Quietmirror/dsh-new-repo/docs/V0.1_设计说明.md

# 右手指握轻量化鼠标 V0.1 一体式试握件 · 设计说明

> 状态：V0.1 试握件已生成并通过自动检查，可以打印。电子装配版只做了参考包络和干涉分析，**尚未设计**。
> 所有数值都可以在 `cad/params_v01.py` 中修改后重新生成；本文中的实测数值来自 `out/v0.1/report.json` 和 `slice_report.json`（自动生成的完整版见 [`out/v0.1/检查报告.md`](../out/v0.1/检查报告.md)）。

## 1 输入数据，以及怎样使用它们

| 数据 | 值 | 本版用途 |
|---|---|---|
| 腕横纹到中指尖 | ≈230 mm（照片 AR 近似） | 只用来判断手偏大、指握时掌根大概率落在鼠标后方，因此后部做短、做低。**不用于缩放外形** |
| 拇指尖到小指尖张开跨度 | ≈190 mm（照片 AR 近似） | 不是掌宽，也不是握宽。**不用于任何尺寸** |
| 掌宽、各指节长度、真实握姿 | 未测 | 没有编造。接触区位置先按经验放置并参数化，试握后再改 |
| 长 90 / 最大外宽 62 / 高 31 / 有效夹持宽 54 | 用户给的试握假设 | 作为构建目标，程序自动校准到这些值 |

Kotinos 用指节长度和屈曲角驱动接触面位置（`DataHand.scad`）。这里没有照搬，因为这些输入还没有测量；接触区改为直接用“位置 + 尺寸 + 深度”参数表达，测到指节数据后可以再接一个手部模型来推算这些参数。

## 2 参考项目

详见 [`参考来源与许可.md`](参考来源与许可.md)。概括：

- **olliebella**（CERN-OHL-P v2）：实际读了 README、22 个 STL（量尺寸、截面）、Fusion 存档的组件清单。采用紧凑比例、“周边框 + 斜筋 + 中部传感器框”的平面底格栅、**四角 + 后中**的五点脚贴布局、滚轮居前。引用了 7.5 mm 圆点脚贴、约 0.65 mm 脚贴厚度、lens-to-surface 2.4 mm、6×6×7.3 微动等数值。
- **Kotinos**（GPL-3.0）：读了 README 和全部 SCAD（MainBuild、DataHand、HandGenerator、PaddleSurfaceGenerator、Data*Paddle、HSK_PCB）及 STL。采用“用最少材料把脚贴、接触面、受力点连成开放骨架”的思路和“指腹接触面是连续光顺曲面片”的做法；接触区参数化。**没有沿用 HSK Pro 的主板孔位。**
- **paw3395-pcb**（CERN-OHL-P v2）：解析了 KiCad 板框和 PAW3395 封装。转接板 15.45×28.0×1.6，传感器开窗 8.6×17.26，镜头底面占位 19.0×21.75。传感器定位框的开口按这个占位加间隙取值。

olliebella 原生三键，这里另加了两个拇指侧键凸台。三个项目的源码和几何都没有复制，V0.1 的几何全部由本仓库代码生成。

## 3 坐标系与建模方法

坐标：X 向右（无名指/小指侧）为正，X=0 为两主键中线；Y=0 为最后端，向前为正；**Z=0 为五个脚贴平台底面**。贴上脚贴后，鼠标垫表面在 Z = −脚贴厚度。

建模流程（`cad/fingertip_mouse.py`）：

1. **外皮**：俯视轮廓（周期样条）的二维距离场，加上随高度变化的侧面偏移（拇指浅凹、无名指支撑、右侧托边），再与顶面高度场（驼峰曲线、横向拱度、两个主键指肚浅碟）做光滑求交，侧面和顶面的过渡圆滑。
2. **精确距离**：对外皮做 marching cubes，用 KD-tree 求每个体素到外皮的真实欧氏距离，因此 1.7 mm 壁厚处处一致（实测见第 6 节）。
3. **壳与骨架**：等厚壳、开放底面；减重窗口用圆角长孔并对边缘做圆滑处理；底部为周边法兰、承力筋、传感器框和五个平台；侧键凸台沿外皮法向长出，外表面随外皮弯曲。
4. **网格**：0.2 mm 体素 marching cubes（脚贴平面正好落在两层体素之间，因此 Z=0 是精确平面）。用 MeshLab 二次误差抽稀到 32 万面，再把抽稀产生的少量自相交面删除、局部补洞，最后复检。
5. **校准**：先用 0.4 mm 体素迭代 4 次，调整轮廓前后范围、名义半宽和右托边宽度，使长度 = 90、夹持宽 = 54、最大外宽 = 62。高度 31 由驼峰曲线直接决定。

可编辑源文件就是 `cad/*.py`，所有参数集中在 `cad/params_v01.py`。另外提供：

- `outer_skin_nurbs_ref_v01.step`：沿 Y 取 56 个外皮截面放样得到的 NURBS 实体，与 SDF 外皮的偏差见第 6 节。用于在 Fusion / SolidWorks 中做装配版的抽壳、分件和开孔。首尾各有约 0.25 mm 的平面端盖。
- `electronics_envelopes_v01.step`：电子参考包络装配体（B-rep）。
- 把带窗口和骨架的试握件转成三角面 STEP 也试过：4 万面就有约 98 MB，没有实用价值，所以没有提供。

## 4 主要参数（默认值）

| 分类 | 参数 | 值 | 说明 |
|---|---|---|---|
| 尺寸 | 长 / 最大外宽 / 高 / 夹持宽 | 90 / 62 / 31 / 54 | 目标，自动校准 |
| 轮廓 | 名义半宽 `plan.half_width` | 校准后约 28.1 | 侧壁名义半宽（不含凹、托边） |
| 驼峰 | `top.crest` | 峰在 Y≈0.54L，后端 0.36H | 后部短而低，避免顶掌 |
| 顶面 | 横向下降 `crown_drop` | 后 7 → 前 3 mm | |
| 主键浅碟 | LMB (−14, 77)，RMB (14, 78.5) | 7.5×10.5 椭圆，深 0.9 | 指肚接触区，连续曲面，无开孔 |
| 拇指浅凹 | Y 54 ±18，Z 10.5 ±7.5 | 深 1.6 | 夹持宽的拇指测点在凹底 |
| 无名指支撑 | Y 66 ±14，Z 12 ±8 | 深 0.5 | |
| 右侧托边 | Y 0.30L–0.72L（两端各 0.14L 渐变），Z 0–9.5 | 校准后外伸约 4.3 | 小指 / 无名指防拖地 |
| 侧键凸台 | 前 SB_front (Y 61.5, Z 20.5)，后 SB_rear (Y 43, Z 20.5) | 15.5×7，凸起 1.6，前端低 4°；边缘约 R1.3；下沿 58° 斜面 | 固定，仅试触达；斜下沿免支撑 |
| 滚轮 | 轴 Y=75.5；开口 9.6×22，R3 角，边缘圆滑 1.6 | 固定滚轮 Ø20×7，露出 2.6 | 18 道浅防滑槽 |
| 壳 | 壁厚 `shell.wall` | 1.7 | 0.4 喷嘴首轮 |
| 底部 | 周边法兰 2.5 宽 × 3 高；承力筋 2.5 宽 × 3 高 | | 筋间 0.8 圆角 |
| 脚贴平台 | Ø8.5，距外轮廓 6 mm | 适配 7–7.5 mm 圆点脚贴 | 四角 + 后中 |
| 传感器框 | 中心 (0, 45)，外 26×30，筋 2.5 | 内开口 21×25 | 容纳镜头占位 19.0×21.75 |
| 底边 | 外缘 45° 倒角 0.6 | | 防硌手、抑制象脚 |
| 窗口 | 顶部 2 条长孔 + 后顶 1 + 左后 1 + 右后 1 + 前脸 1 | 边缘圆滑 1.2 | 均离开接触区 ≥ 2 mm |

## 5 结构说明

**外形**。驼峰最高点在 Y≈48.6，后端低（后端顶约 11 mm），整体后部较短。俯视轮廓前宽后窄，后部收成蛋形。左侧拇指区是一个 1.6 mm 的浅凹，凹下方外壁回到名义位置，形成可以托住拇指的下沿，抬鼠时拇指有着力点。右侧中部有 0.5 mm 的无名指支撑浅凹；下部向外伸出约 4.3 mm 的托边，外表面是内凹曲面，小指可以搭在上面而不拖地。

**侧键凸台**。外表面随外皮弯曲，顶边和两端是清晰的圆角台阶，拇指能摸出位置；下沿做成 58° 斜面。拇指从浅凹向上滑就能顶到侧键，而且打印时下沿不需要支撑，不会在拇指接触面上留下支撑痕。

**接触区不开孔**。主键指肚浅碟、拇指浅凹、无名指支撑、小指托边、两个侧键凸台全部是连续光顺曲面。程序检查了每个接触区到最近减重窗口和滚轮开口的距离（第 6 节）。滚轮开口边缘、侧键凸台边缘、窗口边缘都做了圆滑过渡（约 R1–1.4）；外缘底边是 0.6 mm 倒角。

**开放骨架**。顶部驼峰后坡两侧各开一条 8.5×30 的长孔，中间保留 10.5 mm 的脊梁；后顶一个横向小孔；左后、右后侧壁各一个斜向长孔；前脸一个横向长孔。底面大部分开放。

**底部承力路径**。周边法兰沿外壁内侧围一圈；承力筋从五个平台出发，在中部汇到传感器框；前横筋连接两个前平台；传感器框左右各有一根横向拉筋连到侧壁，正好在拇指 / 无名指夹持的高度下方，提高夹持刚度。五个平台、法兰、筋和传感器框都在 Z=0 平面内，**由同一个平面切出，严格共面**，并连成一个实体。

> 关于“只保留五个平台”：V0.1 中法兰和筋的底面也在 Z=0（与 olliebella 底板相同）。这样整块底面直接贴床打印，不需要支撑，共面性也最好。贴上脚贴后，筋底距垫面等于脚贴厚度（约 0.65 mm）。如果在软布垫上发现筋刮垫，可以把 `bottom.bottom_relief` 设为 0.3–0.5，让平台以外的部分抬高；代价是这些部分在打印时悬空，需要支撑。

**V0.1 占位件（装配版删除）**。固定滚轮装在一个立在前横筋和中纵筋上的底座上，与外壳之间留约 1.2 mm 间隙，不碰开口边缘。两个主键浅碟正下方各有一根 Ø4.5 受力柱，从前横筋立到壳内，用来模拟按键支撑，避免试握时顶面发软。

## 6 自动检查结果

（`out/v0.1/report.json`，完整表格见 `out/v0.1/检查报告.md`）

| 检查项 | 结果 |
|---|---|
| 尺寸 长 × 宽 × 高 | **90.02 × 62.02 × 31.00**（目标 90 × 62 × 31）；PrusaSlicer 读入 62.02 × 90.02 × 31.00 |
| 有效夹持宽 | **54.00**：拇指测点 (−26.6, 54, 10.5) 到无名指测点 (27.4, 66, 12) 的 X 向距离 |
| 外壳宽（不含侧键凸台） | 60.64；侧键凸台另外凸出约 1.5 |
| 单一连通实体 | 是：STL 写盘后回读为 1 个实体，PrusaSlicer `parts = 1` |
| 封闭网格 | 是：0 边界边、0 非流形边、0 退化面；manifold3d 通过；PrusaSlicer `manifold = yes` |
| 自相交 | **0**（MeshLab，检测对象是写盘后的 float32 STL）。原始 marching-cubes 网格 143 万面，0 自相交；抽稀到 32 万面后，在受力柱侧面和前角内壁出现 12 个，已删除并局部补洞。交付网格与原始网格的 Hausdorff 距离最大 0.069 mm |
| 最薄壁 | 外壳 P1 1.69 / 中位 1.70，最小 1.40（单个点，右后窗口附近）。窗口和滚轮开口的圆角收边最小 0.95、P5 1.50，属于圆角收口，符合预期 |
| 五脚共面 | 五个平台由同一平面 Z=0 切出；回读 STL 后底面顶点 Z 偏差 ≤ 0.003 mm（float32 舍入量级）；每个平台都能完整放下 7.5 mm 圆点脚贴 |
| 接触区避让 | 所有减重窗口距接触区 ≥ 3.7 mm（要求 ≥ 2）；主键浅碟距滚轮开口 1.73 / 1.87 mm（要求 ≥ 1.5） |
| 固定滚轮 | 与外壳最小间隙 1.19 mm，高出两侧顶面 2.6 mm |
| 体积 | 21.05 cm³ = 壳 13.45 + 底部法兰 1.73 + 筋/传感器框/平台 2.41 + 占位件 3.44 |
| 估重 | 100% 实心 PLA 26.1 g；切片后零件本体 **25.2 g**（2 h 35 min），连同树状支撑共耗材 **37.3 g、约 4 h 06 min** |
| 支撑是否碰外表面 | 位于外皮以外、离零件 < 0.6 mm 的支撑挤出点只有 2 个（左后窗口下沿附近）；指肚区、拇指区、侧键、托边都没有支撑 |
| NURBS 参考面 | 有效 B-rep，相对 SDF 外皮最大偏差 0.015 mm |

（PLA 26.1 g 中有 3.44 cm³ ≈ 4.3 g 是装配版会删除的占位件。）

## 7 打印

- **朝向**：按模型原样放置，底面（五个平台和底格栅）贴床，Z 向上，不需要旋转。切片器里核对尺寸应为 X 62.0 × Y 90.0 × Z 31.0（PrusaSlicer `--info` 读数见第 6 节）。
- **支撑**：只开“仅从热床生成”的树状 / organic 支撑。需要支撑的是壳体内顶面（驼峰内侧）、窗口上沿、滚轮下半圈两侧和受力柱顶端，见 `img/overhang_sheet.png`（悬垂 > 45° 共约 2800 mm²，几乎全在 Z 15–30 的壳内顶面）。侧键凸台下沿已经做成 58° 斜面，不需要支撑。`cad/support_check.py` 解析 G-code 的结果：外皮以外、贴近零件的支撑挤出点只有 2 个（左后窗口下沿）。指肚区、拇指区、侧键、托边都不碰支撑，支撑从开放底面和窗口取出。
- **参数**：0.4 喷嘴，0.2 层高，3 圈壁（1.7 mm 壁基本全由周长线组成），顶底 4/3 层，填充 20% gyroid（只影响平台和筋），首层象脚补偿 0.15。配置文件 `cad/prusa_v01.ini`。
- **材料**：PLA 即可；希望更接近成品手感可用 PETG。
- **后处理**：拆支撑；用平板加细砂纸轻磨五个平台，然后贴脚贴，并记录脚贴实测厚度。
- **核对**：在玻璃板上检查五脚是否同时着地；测量长、宽、高和夹持宽（拇指测点 Y54 Z10.5、无名指测点 Y66 Z12）。

## 8 电子装配版：参考包络、尺寸链和干涉

目标配置：PAW3950、2.4 GHz 无线 1000 Hz、左右主键、中键 / 滚轮、两个拇指侧键。
供体是用户称为“ATK 蜻蜓 A1 Plus”的鼠标，或半组装的自制主板。**供体的具体型号、传感器版本、PCB 外形和孔位都没有确认**，所以本节不假定它使用 PAW3950，也没有给出任何供体孔位。PAW3950 只是传感器型号，不对应统一的主板尺寸。无线 1K 要靠主板、固件和配套接收器共同实现，与外壳无关，这里只为天线留出净空。

包络来源标记：**M** 从开源文件实测，**B** 来自参考 BOM / README，**S** 行业常见标称，**E** 估计。E 类只用来预留空间，**不是装配尺寸，也不是孔位**。

| 包络 | 尺寸 / 位置 | 来源 |
|---|---|---|
| 镜头底面占位 | 19.0×21.75，光学中心偏置按封装，Z 1.75–3.0 | M（paw3395-pcb B.CrtYd）+ 尺寸链 |
| 传感器本体 PAW3950 | 12.5×18×4.5，板上 | E |
| 参考转接板 | 15.45×28.0×1.6，光学中心偏 4.6 | M（paw3395-pcb） |
| 主键微动 L/R | 6×6×7.3，在两浅碟下 | B（olliebella BOM） |
| 滚轮 / 轴 / 编码器 / 中键 | Ø20×7；轴 Ø2×19；编码器 6.5×12.5×(到轴心+6.25)；中键 6×6×5 | E |
| 侧键微动 ×2 + 侧键小板 | 6×6×4.3；板 34×10×1.0，平行于拇指侧内壁 | E |
| 电池 | 301230（30×12×3.0）；备选 602030（30×20×6.0），平放后部 | B / E |
| 电池插头 | PH2.0 2P 6×4.5×6 | E |
| USB-C | 插座 8.94×7.35×3.26，前脸居中；插头护套净空 12.4×15×6.6 | S/E |
| 电源开关 | 9×4×3.5，挂在主板下方，从底面拨动 | E |
| 2.4 GHz 天线净空 | 8×18×9，主板右前角 | E |
| 走线 | Ø2 线束：侧键板→主板，电池→主板 | E |

**Z 向尺寸链**（传感器轴线垂直于垫面，PCB 必须平行于 Z=0）：

```
垫面            z = −t_skate                          = −0.65   (t_skate：脚贴实测厚度，估计)
镜头基准面      z = −t_skate + d_lens_surface          =  1.75   (d = 2.40 ±0.2，olliebella README；以镜头 datasheet 为准)
PCB 底面        z = 镜头基准面 + h_lens→PCB             =  3.00   (h_lens→PCB = 1.25 为估计值，必须实测)
PCB 顶面        z = PCB 底面 + t_PCB                   =  4.60   (t_PCB = 1.6，转接板实测；供体未知)
```

V0.1 的筋顶在 Z=3.0。只有当 h_lens→PCB 实测正好是 1.25 时，主板才能直接平放在筋上。若实测更大，需要加垫高柱；若更小，传感器框和附近的筋要局部降低。PCB 底面高度只能由“真实主板 + 镜头 + 底面 + 脚贴”的尺寸链确定，不能用 V0.1 的筋高反推。

**干涉结论**（`out/v0.1/检查报告.md` 第 8 节；图见 `img/envelopes_sheet.png`、`img/sections_sheet.png`）：

1. **编码器：干涉，侵入 0.85 mm → 需改布局或壳体。** 滚轮 Ø20、高出顶面 2.6 mm，轴心在 Z≈18.1，比估计的 PCB 顶面（4.6）高 13.5 mm。估计的编码器本体上沿到轴心 +6.25，即 Z≈24.4，撞到滚轮开口旁的外壳内顶面。可选办法：按选定编码器核对轴高；把滚轮换成 Ø18 或减少露出量，降低轴心；把滚轮区外壳局部加高；或者用独立的滚轮支架小板。
2. **USB-C：需要在前脸开口。** 插座前端应贴齐前脸，需要在 Z≈3.6–6.9、X ±4.5 处开约 10×4.5 mm 的口。V0.1 前脸窗口在 Z 5–10，位置对不上，装配版应把它改成 USB-C 开口，或把窗口移开。插头护套下沿离垫面约 3 mm，可以接受。插座后端在前横筋之前，不干涉。
3. **电源开关：干涉，且穿过离地余量 → 需改选型或布局。** 按“挂在主板下方、从底面拨动”布置时，主板底面（Z 3.0）以下只有 3.0 mm，再留 0.5 mm 离地余量，只剩 2.5 mm。估计 3.5 mm 高的开关加拨杆会低于脚贴平面 0.47 mm，还会撞筋。可选办法：选总高 ≤ 2.3 mm 的超薄拨动开关，放在筋之间的空档；或者用装在主板边缘的侧拨开关，从侧壁窗口拨动；或者改成按键式开关。
4. **电池：可行。** 301230 平放在后部筋上（垫 0.5 mm 泡棉），最小间隙 0.68 mm。602030 也放得下（间隙 0.5 mm），但会和按 301230 布置的插头位置重叠，换大电池时插头要挪到电池侧面。
5. **侧键：可行。** 两个侧键微动（估计 6×6×4.3）贴在凸台内侧，接触深度 ≤ 0.13 mm，是有意的贴合；侧键小板离内壁 0.53 mm。具体高度要按选定的开关重新算。
6. **主键：可行，但需要压杆。** L/R 微动（6×6×7.3）放在浅碟正下方的主板上，顶部到外壳内表面还有约 10 mm，需要按键压杆。V0.1 受力柱的位置就是将来微动 / 压杆的位置。
7. **传感器：可行。** 镜头占位 19.0×21.75（M）落在传感器框 21×25 的开口内，四周间隙 ≥ 1.0 mm；PAW3395 参考转接板平放在筋顶（接触 0.1 mm，那是支承面）。PCB 底面的真实高度取决于实测的 h_lens→PCB，见上面的尺寸链。
8. **天线净空：可行。** 放在主板右前角，范围内只有塑料（外壳和筋），与电池、编码器、走线都不重叠；右主键微动在它前方约 4.5 mm，最终以天线厂商的净空要求为准。
9. **主板可用最大外形**：Z 3.0–7.6、离壁 0.5 mm 的可用区域包围盒约 X −25.6…26.2、Y 3.7…87.9，面积约 3900 mm²（`main_board_keepin_outline.dxf/.csv`）。这是外壳允许的上限；扣掉后部电池区（Y 约 11–33）后，主板实际可用约 Y 33–88。测到供体主板后先和这条轮廓比较：放不下就改壳体尺寸或改板型（例如把传感器做成独立小板）。

**结论**：按当前估计包络，V0.1 外形可以容纳传感器、主键 / 侧键、电池和天线净空。编码器高度、USB-C 开口和电源开关三处需要在装配版中改布局或选型；改哪一处要等真实尺寸确定。

## 9 装配版待测尺寸清单

**供体 / 主板**

1. 供体的准确型号、PCB 版本号，以及传感器丝印（是否为 PAW3950、具体后缀）
2. 主板外形轮廓（建议平板扫描 + 卡尺）、厚度、所有安装孔的位置和孔径
3. 主板正面 / 背面最高元件高度，以及禁止压到的区域
4. 传感器光学中心在主板上的坐标，镜头型号，镜头卡扣形状
5. 镜头基准面到 PCB 底面的高度 h_lens→PCB，以及镜头底面到垫面的设计距离 d_lens_surface（datasheet）
6. 主键微动型号、本体尺寸、触点高度（相对 PCB 顶面）、行程和动作力
7. 编码器型号、安装方式、轴心相对 PCB 的高度，滚轮直径、宽度、轴长和轴径
8. 中键微动的位置和高度
9. 侧键微动型号；侧键小板外形、孔位和排线长度
10. 电池型号、尺寸（含保护板）、插头型号及线长
11. 天线类型和位置（PCB 天线 / 陶瓷天线 / 外接），厂商要求的净空
12. USB-C 插座位置、离 PCB 的高度、插头护套尺寸
13. 电源开关位置、拨杆方向、行程
14. 主板与侧键板、编码器之间的连接方式（排线 / 焊线）及走线路径

**手和使用**

15. 掌宽、各指节长度、指握姿态下拇指 / 无名指 / 小指的实际触点（用 V0.1 试握件标记）
16. 实际使用的脚贴直径和厚度、鼠标垫软硬

**打印件**

17. V0.1 实测外形尺寸和五脚共面性，与模型对比（确认打印机的尺寸补偿）

## 10 试握反馈

按 [`试握反馈表.md`](试握反馈表.md) 逐项记录，重点看：

1. **握宽**：拇指浅凹和无名指支撑之间的 54 mm 是否合适；托边宽度
2. **顶掌**：掌心 / 掌根是否碰到驼峰或后部
3. **手指拖地**：无名指、小指、拇指是否拖垫；托边是否起作用
4. **滚轮 / 侧键触达**：食指移到滚轮、拇指上移到两个侧键是否需要改握姿
5. **抬鼠稳定性**：抬起时是否滑脱、翻转；放下时五脚是否同时着地

## 11 下一轮（V0.2）计划

- 按试握反馈改长宽高、接触区和侧键位置（都只需改 `params_v01.py`）
- 壁厚逐轮减到 1.4 → 1.2 mm，顶部和侧壁窗口加大，筋高 3 → 2.5 mm；以切片重量和夹持刚度为准
- 测到供体尺寸后：删除占位件，按真实主板做安装柱 / 卡扣、镜头卡位和 USB-C 开口，主键和侧键改为分体活动件，并按上一节的干涉结论调整布局
