Quietmirror/dsh-new-repo/docs/试握反馈表.md

# V0.1 试握反馈表

打印件：`out/v0.1/fingertip_v01_trial_grip.stl`。先贴好五个圆点脚贴（记录脚贴厚度），在常用鼠标垫上以平时的指握姿势使用。
主键、侧键和滚轮在 V0.1 中都是固定的，这一轮只评价外形和能否够到，不评价点击手感和回弹。

每项打分 1–5（3 = 合适），写清方向和大致幅度（mm），例如“握宽 2：太宽，约窄 2 mm”。

## 0 基本信息

| 项目 | 记录 |
|---|---|
| 打印材料 / 壁厚设置 / 实际重量 (g) | |
| 脚贴型号、直径、实测厚度 (mm) | |
| 鼠标垫类型（布垫软/硬、玻璃、树脂） | |
| 平时使用的鼠标型号与尺寸（对照） | |
| 使用场景（FPS 跟枪 / 甩枪 / 办公） | |

## 1 握宽（夹持宽 54 mm，最大外宽 62 mm）

| 问题 | 分数 | 说明 |
|---|---|---|
| 拇指与无名指之间的夹持宽度：太窄 1 … 5 太宽 | | |
| 拇指浅凹的位置（前后、高低）与深度 | | 拇指实际落点 Y≈___ Z≈___ |
| 右侧无名指支撑面的位置 | | 无名指实际落点 Y≈___ Z≈___ |
| 右侧托边（防拖地）宽度 / 高度：小指是否舒服地搭在托边上 | | |
| 夹紧时是否感到外壳变形或发出响声 | | |

## 2 顶掌（高 31 mm，后部短低）

| 问题 | 分数 | 说明 |
|---|---|---|
| 正常指握时掌心 / 掌根是否碰到背部 | | 碰到的位置 Y≈___ |
| 驼峰高度：太低 1 … 5 太高 | | |
| 驼峰前后位置：太靠后 1 … 5 太靠前 | | |
| 长度 90 mm：太短 1 … 5 太长 | | 指尖到前沿的余量 ___ mm |

## 3 手指拖地

| 问题 | 分数 | 说明 |
|---|---|---|
| 无名指 / 小指是否拖到鼠标垫 | | 哪根手指，什么动作时 |
| 拇指是否拖到鼠标垫 | | |
| 托边下缘是否刮垫（重压、斜压时） | | |

## 4 滚轮 / 侧键触达

| 问题 | 分数 | 说明 |
|---|---|---|
| 食指从主键移到滚轮是否顺手（滚轮 Y≈75.5） | | 希望前移/后移 ___ mm |
| 滚轮露出高度（约 2.6 mm）与开口宽度 | | |
| 前侧键（SB_front，Y≈61.5，Z≈20.5）能否不改握姿按到 | | |
| 后侧键（SB_rear，Y≈43，Z≈20.5）能否不改握姿按到 | | |
| 侧键高度：太低 1 … 5 太高；凸起 1.6 mm 是否足够分辨 | | |
| 两侧键间距是否容易误触 | | |
| 主键指肚浅碟位置（LMB X=-14 Y=77，RMB X=14 Y=78.5） | | 指肚实际落点 |

## 5 抬鼠稳定性

| 问题 | 分数 | 说明 |
|---|---|---|
| 抬起时是否容易滑脱 | | |
| 抬起时是否左右翻转 / 前后倾斜 | | |
| 放下时五个脚贴是否同时着垫，有无翘动 | | |
| 重心感觉（前 / 后 / 左 / 右） | | |

## 6 其他

| 问题 | 记录 |
|---|---|
| 窗口边缘、凸台边缘是否硌手 | |
| 表面层纹、支撑残留是否影响判断 | |
| 最想改的三处（按优先级） | 1. 2. 3. |

## 7 附加测量（建议同时补充）

- 掌宽（掌指关节处）、食指 / 中指 / 无名指 / 小指 / 拇指各指节长度
- 指握姿态下：指尖到掌根距离；手掌离桌面的高度
- 打印件实测：长、宽、高、五脚是否共面（放在玻璃板上用塞尺检查）
