Quietmirror/dsh-new-repo/out/v0.1/检查报告.md

# V0.1 试握件自动检查报告

由 `cad/build_v01.py` 生成的 `report.json` 转写；数值均为本次构建实测，单位 mm。

## 1 外形尺寸（网格包围盒，Z 自脚贴平台平面起算）

| 项目 | 目标 | 实测 |
|---|---|---|
| 长 Y | 90.0 | 90.02 |
| 最大外宽 X（含右托边、侧键凸台） | 62.0 | 62.02 |
| 外壳宽（不含侧键凸台） | — | 60.64 |
| 高 Z（贴脚贴后约 +0.65） | 31.0 | 31.00 |
| 有效夹持宽（拇指点→无名指点，X 向） | ≈54 | 54.00 |

拇指测点 (-26.6, 54.0, 10.5)，无名指测点 (27.4, 66.0, 12.0)。

## 2 网格检查（交付 STL）

| 项目 | 结果 |
|---|---|
| 面数 / 顶点数 | 319780 / 159856 |
| 封闭（watertight） | True |
| 实体数（连通分量） | 1 |
| 边界边 / 非流形边 / 退化面 | 0 / 0 / 0 |
| 自相交面（MeshLab） | 0 |
| manifold3d 校验 | Error.NoError |
| 体积 | 21.05 cm³ |
| 原始 marching-cubes 网格 | 1431776 面，封闭=True，实体=1，自相交=0 |
| 抽稀后自相交修复（每轮检出面数，按 float32 精度） | [12, 0]，修复位置 [[-23.0, 83.9, 6.2], [-11.9, 79.5, 12.4], [-16.1, 77.9, 6.0], [23.6, 83.2, 6.6], [12.1, 77.5, 17.0], [16.1, 77.9, 8.4]] |
| 交付网格 vs 原始网格 Hausdorff | 最大 0.069，平均 0.0004 |

## 3 五个脚贴平台

| 平台 | 中心 X, Y | 平台内底面面积 mm² | 底面 Z 范围 | 7.5 mm 圆点脚贴完全落在平面上 |
|---|---|---|---|---|
| RC | 0.0, 5.78 | 51.0 | 0.0000 … 0.0011 | True |
| RL | -19.98, 23.4 | 50.9 | 0.0000 … 0.0026 | True |
| RR | 23.47, 23.4 | 52.2 | 0.0000 … 0.0000 | True |
| FL | -19.44, 78.75 | 52.4 | 0.0000 … 0.0027 | True |
| FR | 19.44, 78.75 | 51.6 | 0.0000 … 0.0000 | True |

五平台底面顶点 Z 最大偏差 **0.0027 mm**；全模型最低点 Z = 0.0000。

## 4 壁厚（沿内法向射线穿过实体场，亚体素插值）

| 区域 | 样本 | 最小 | P1 | P5 | 中位 |
|---|---|---|---|---|---|
| 外壳（排除窗口/滚轮开口圆角 1.5 mm 带） | 72154 | 1.40 | 1.69 | 1.70 | 1.70 |
| 窗口/滚轮开口圆角边 | 13014 | 0.95 | 1.25 | 1.50 | 1.70 |

薄点（< 1.4 mm，已排除圆角边）：

| 位置 X,Y,Z | 最小 | 顶点数 |
|---|---|---|
| [16.0, 7.0, 12.0] | 1.40 | 1 |

## 5 接触区与开孔

| 接触区 | 距最近减重窗口 | 距滚轮开口 | 通过 |
|---|---|---|---|
| lmb_dish | 10.48 | 1.73 | True |
| rmb_dish | 3.71 | 1.87 | True |
| thumb_groove | 4.27 | 22.49 | True |
| ring_rest | 14.60 | 19.07 | True |
| pinky_lip | 6.88 | 22.97 | True |
| boss_SB_front | 14.15 | 18.93 | True |
| boss_SB_rear | 4.46 | 25.76 | True |

固定滚轮占位件与外壳最小间隙 1.19 mm；滚轮顶 Z=28.11，该处外壳顶面 Z=25.51。

## 6 体积 / 重量

| 部分（体素估计） | 体积 cm³ |
|---|---|
| shell_with_windows_and_side_bosses | 13.45 |
| bottom_perimeter_flange | 1.73 |
| ribs_sensor_frame_pads | 2.41 |
| v01_placeholders_wheel_and_posts | 3.44 |

实体体积 21.05 cm³ → 100% 实心估重 PLA 26.11 g / PETG 26.74 g。

切片（PrusaSlicer CLI，`cad/prusa_v01.ini`：0.4 喷嘴、0.2 层高、3 圈壁、20% gyroid、PLA 1.24 g/cm³）：

| 方案 | 耗材 g | 耗材 m | 预计时间 | 层数 |
|---|---|---|---|---|
| 零件本体（不含支撑） | 25.17 | 8.44 | 2h 34m 43s | 155 |
| 实际打印（含树状支撑） | 37.29 | 12.50 | 4h 6m 9s | 155 |

切片器读入尺寸：62.022278 × 90.018553 × 31.000477，manifold=yes，parts= 1，volume=21052.451172。

支撑位置检查（`cad/support_check.py`，以 NURBS 外皮为界）：支撑挤出点 221501，其中接触面（interface）2638；**外皮以外、距零件表面 < 0.6 mm 的支撑点 2**；外皮以外的全部支撑点 9625（多为树状支撑在热床上的底座）。

外皮以外的支撑分布（10 mm 网格）：{'x-30 y10 z0': 1, 'x-30 y20 z5': 1}

## 7 悬垂（打印朝向：底面贴床）

悬垂 > 45° 面积 2801 mm²，贴床面积 1580 mm²；按高度分布：{'0-5': 1, '5-10': 2, '10-15': 84, '15-20': 320, '20-25': 1000, '25-30': 1394, '30-35': 0}。

## 8 电子参考包络干涉（骨架已删除 V0.1 占位件）

尺寸链（Z）：mousepad_surface_z = -0.65，lens_reference_plane_z = 1.75，pcb_bottom_z = 3.00，pcb_top_z = 4.60

| 包络 | 来源 | 状态 | 与骨架重叠 mm³ | 最大侵入 mm | 最小间隙 mm |
|---|---|---|---|---|---|
| lens_courtyard | M: paw3395-pcb PAW3395.kicad_mod B.CrtYd, relative to optica | **ok** | 0.0 | 0.00 | 1.03 |
| sensor_PAW3950_body | E: PAW3950 package envelope, replace with datasheet outline | **ok** | 0.0 | 0.00 | 3.50 |
| ref_paw3395_breakout_pcb | M: paw3395-pcb Edge.Cuts 15.45x28.0, optical centre 4.6 mm o | **CONTACT(<=0.3mm, resting/fillet)** | 1.0 | 0.10 | -0.10 |
| sensor_optical_axis | axis marker (vertical, perpendicular to the pad) | **ok** | 0.0 | 0.00 | 10.23 |
| switch_LMB | B: olliebella BOM Kailh CMI627301D07 6x6x7.3 | **ok** | 0.0 | 0.00 | 1.50 |
| switch_RMB | B: olliebella BOM Kailh CMI627301D07 6x6x7.3 | **ok** | 0.0 | 0.00 | 1.39 |
| wheel | E: same as V0.1 dummy wheel (D20 x 7) | **ok** | 0.0 | 0.00 | 0.80 |
| wheel_axle | E: axle diameter / length | **ok** | 0.0 | 0.00 | 3.09 |
| encoder | E: vertical encoder body; olliebella uses ALPS EC05E1220401  | **INTERFERENCE** | 70.9 | 0.85 | -0.85 |
| switch_MMB | E: middle-click switch | **ok** | 0.0 | 0.00 | 1.50 |
| switch_SB_front | E: generic 6x6 tact; replace with chosen side switch | **CONTACT(<=0.3mm, resting/fillet)** | 0.1 | 0.13 | -0.13 |
| switch_SB_rear | E: generic 6x6 tact; replace with chosen side switch | **CONTACT(<=0.3mm, resting/fillet)** | 0.0 | 0.08 | -0.08 |
| side_button_pcb | E: two-switch side PCB | **ok** | 0.0 | 0.00 | 0.53 |
| battery_301230 | B: olliebella BOM 301230 LiPo (TxWxL naming) | **ok** | 0.0 | 0.00 | 0.68 |
| battery_plug | E: PH2.0 2P (olliebella CAD lists PH2.0 2P socket) | **ok** | 0.0 | 0.00 | 1.50 |
| usb_c_receptacle | S/E: mid-mount Type-C receptacle typical body | **NEEDS_SHELL_CUTOUT** | 15.1 | 0.73 | -0.73 |
| usb_c_plug_overmold_clearance | E: cable overmold clearance in front of the face | **ok** | 0.0 | 0.00 | 0.60 |
| power_switch | E: MSK-12C02 / MSK-1153 slide switch incl. lever travel | **INTERFERENCE+BELOW_0.5mm** | 7.2 | 0.47 | -0.47 |
| antenna_keepout_2G4 | E: 2.4 GHz PCB antenna + clearance, position depends on boar | **ok (only plastic inside; keep metal, battery and wires out)** | 0.0 | 0.00 | 0.10 |
| wire_side_buttons | E: 2-3 x 28-30 AWG silicone | **ok** | 0.0 | 0.00 | 1.90 |
| wire_battery | E: 2-3 x 28-30 AWG silicone | **ok** | 0.0 | 0.00 | 1.10 |
| battery_602030 | E: larger 602030 option (TxWxL naming) | **ok** | 0.0 | 0.00 | 0.50 |

包络之间的重叠：

- battery_plug × battery_602030：69.1 mm³

主板可用最大外形（Z 3.00–7.60，0.5 mm 间隙）：包围盒 [[-25.63, 3.7], [26.17, 87.9]]，面积 3899 mm²；轮廓见 `main_board_keepin_outline.dxf/.csv`。

## 9 NURBS 外形参考 STEP

`outer_skin_nurbs_ref_v01.step`：56 个截面放样，B-rep 有效=True，与 SDF 外形偏差 最大 0.015 / P99 0.007 / 平均 0.0012 mm（skin beyond the first/last section (small flat end caps) excluded）。
