Quietmirror/dsh-new-repo/out/v0.1/img/contact_iso.png

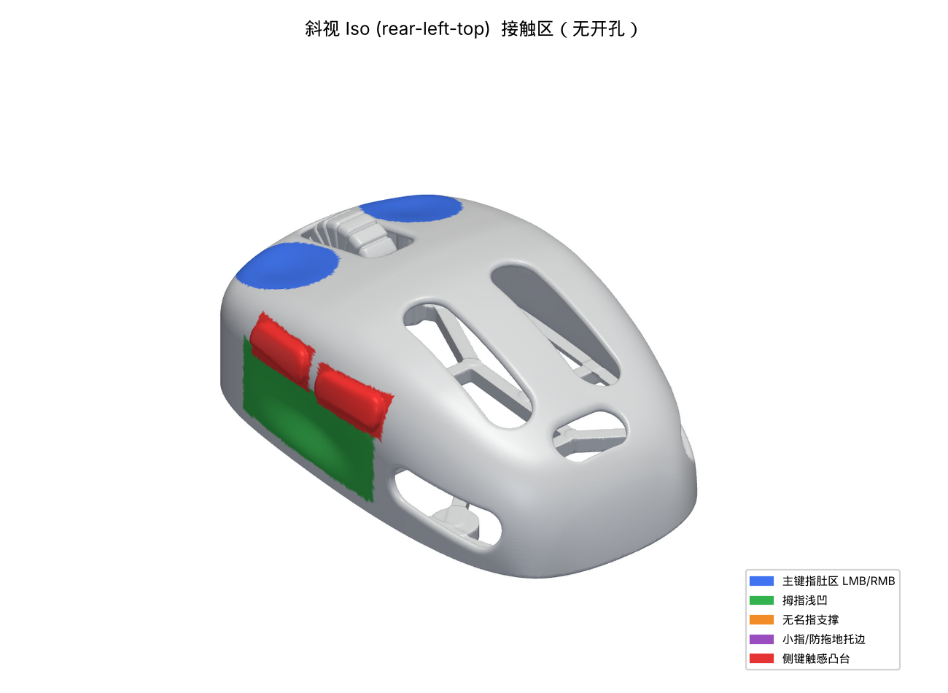
out/v0.1/img/contact_iso.png
