Quietmirror/dsh-new-repo/out/v0.1/img/contact_iso_fr.png

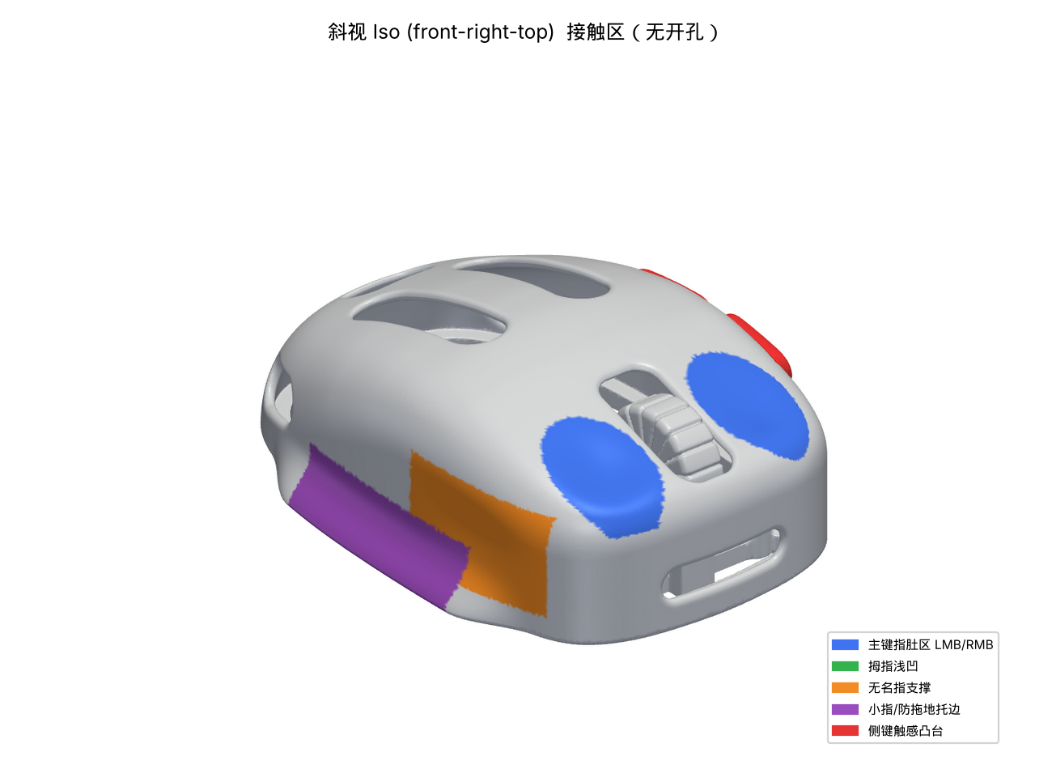
out/v0.1/img/contact_iso_fr.png
