Quietmirror/dsh-new-repo/out/v0.1/img/contact_left.png

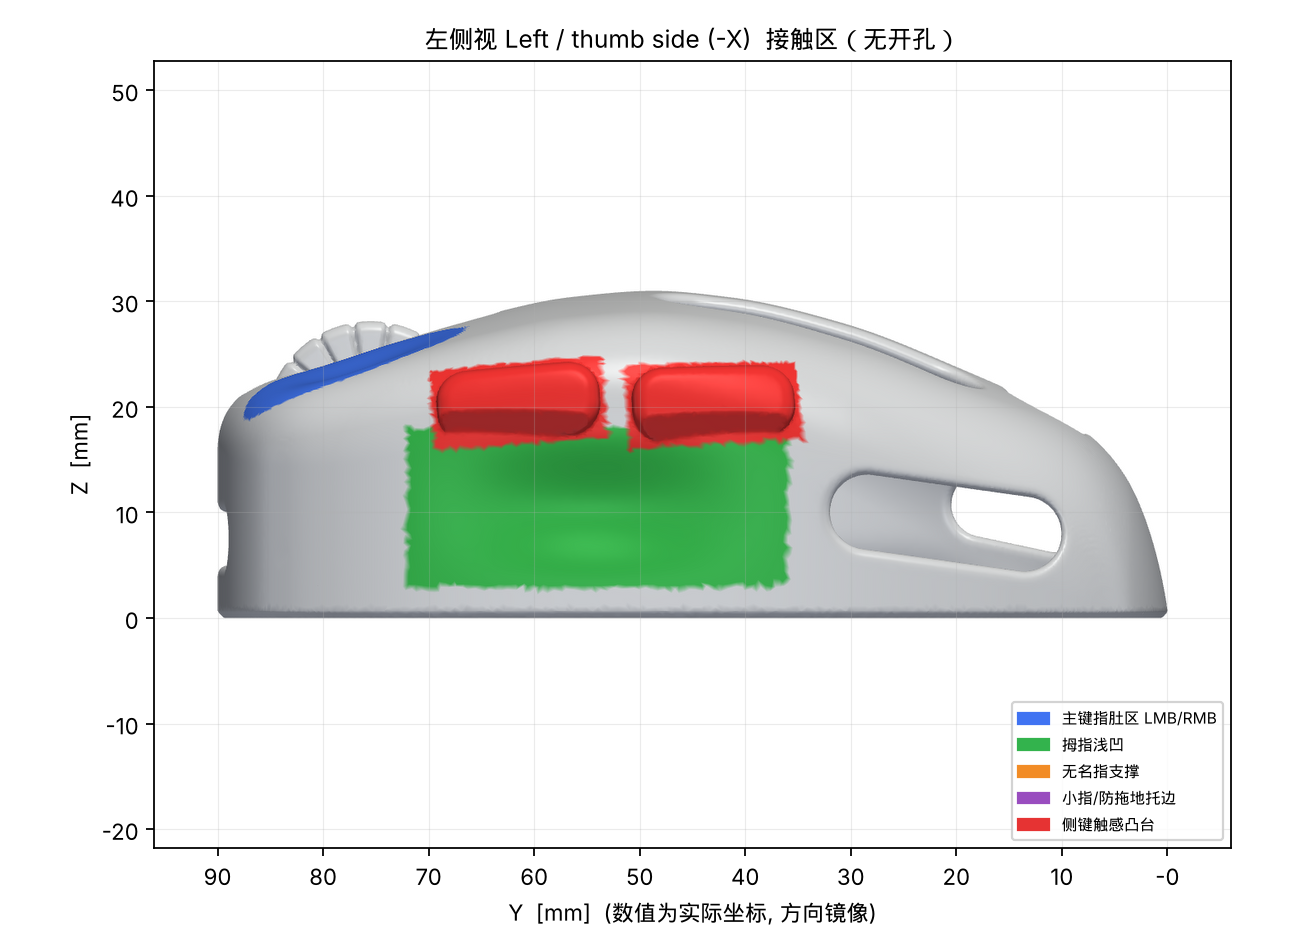
out/v0.1/img/contact_left.png
