Quietmirror/dsh-new-repo/out/v0.1/img/contact_right.png

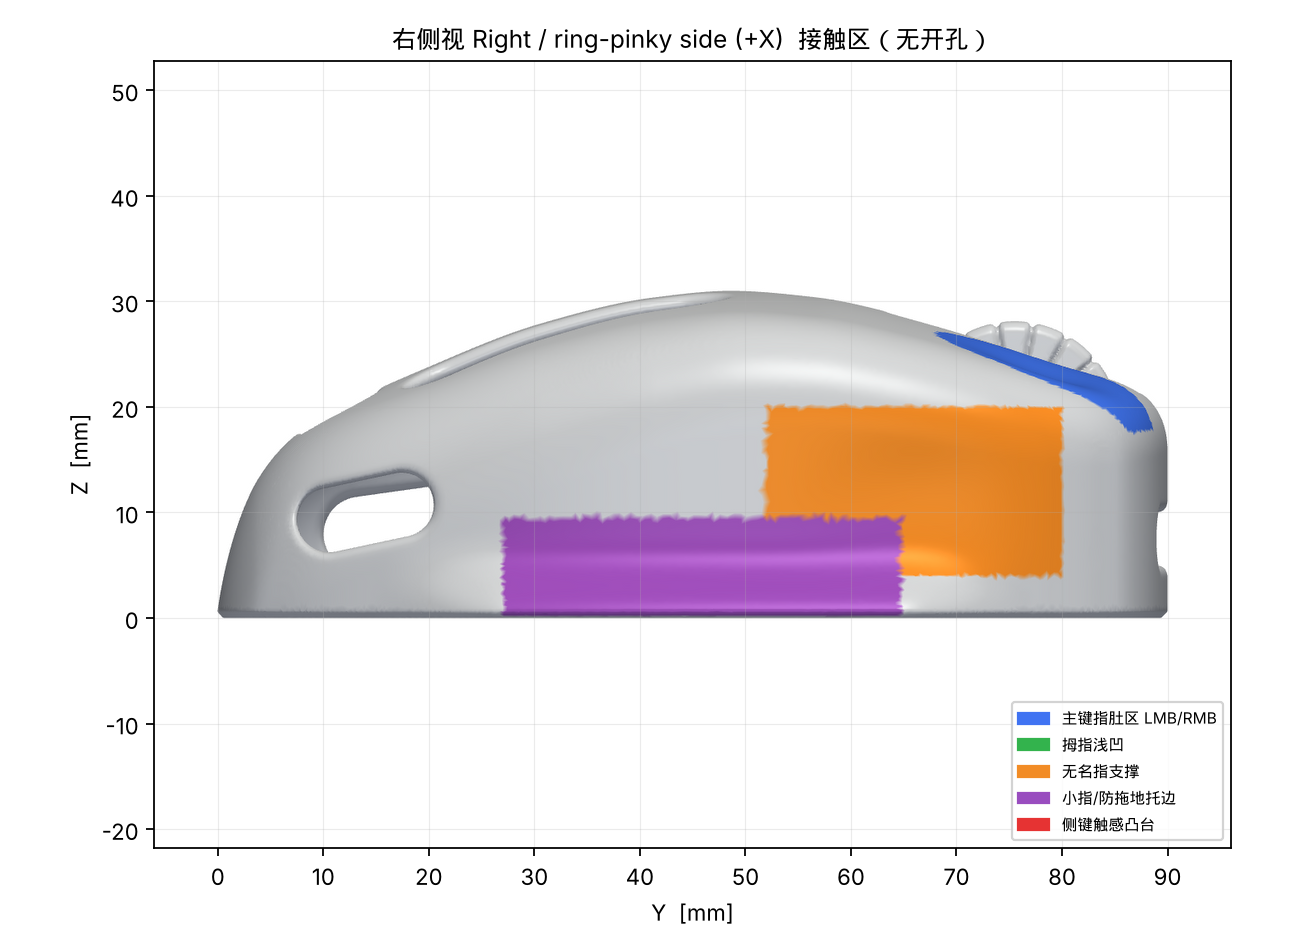
out/v0.1/img/contact_right.png
