Quietmirror/dsh-new-repo/out/v0.1/img/contact_zones_sheet.png

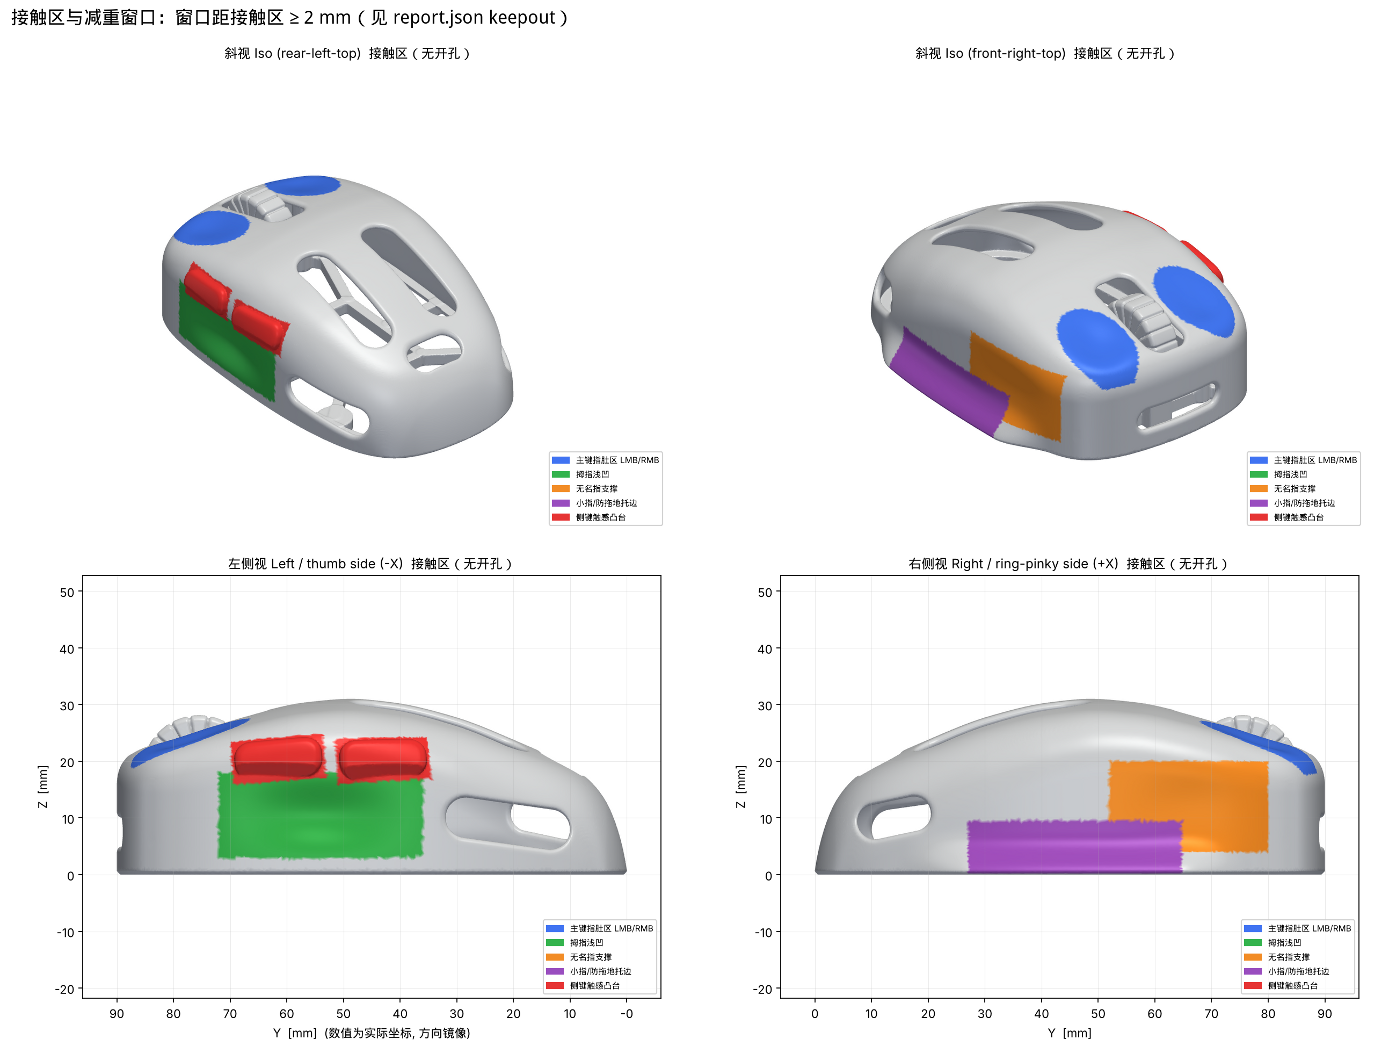
out/v0.1/img/contact_zones_sheet.png
