Quietmirror/dsh-new-repo/out/v0.1/img/envelopes_front.png

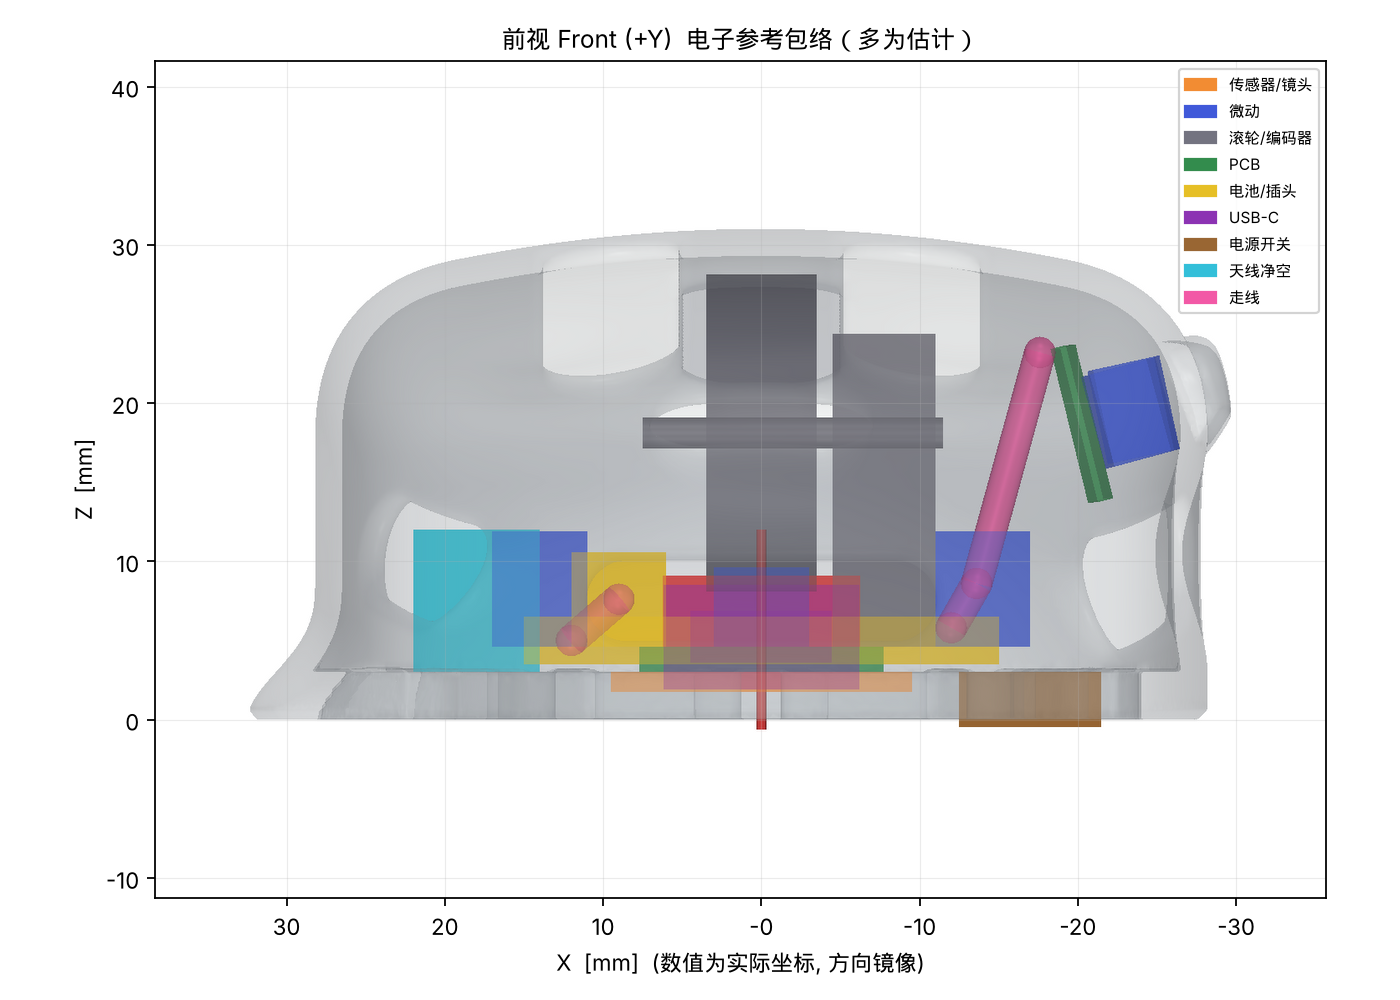
out/v0.1/img/envelopes_front.png
