Quietmirror/dsh-new-repo/out/v0.1/img/envelopes_iso.png

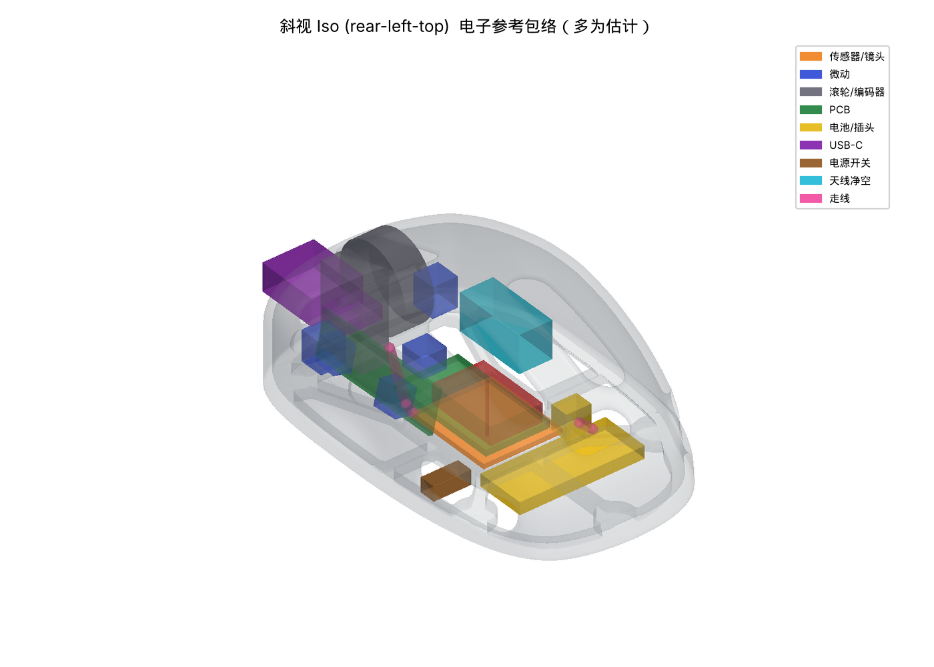
out/v0.1/img/envelopes_iso.png
