Quietmirror/dsh-new-repo/out/v0.1/img/envelopes_left.png

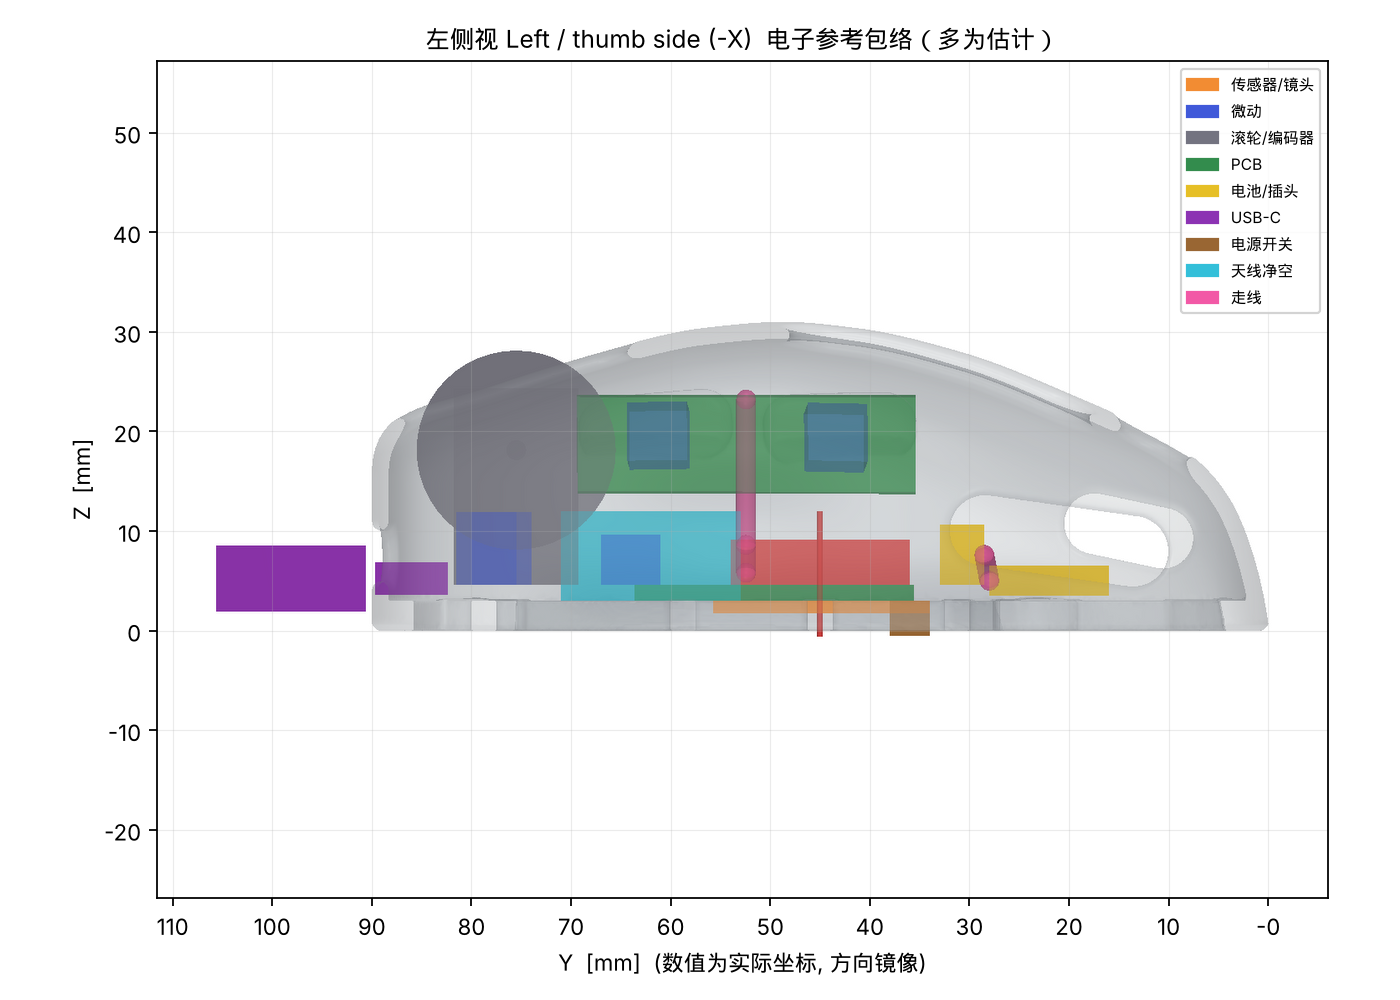
out/v0.1/img/envelopes_left.png
