Quietmirror/dsh-new-repo/out/v0.1/img/envelopes_sheet.png

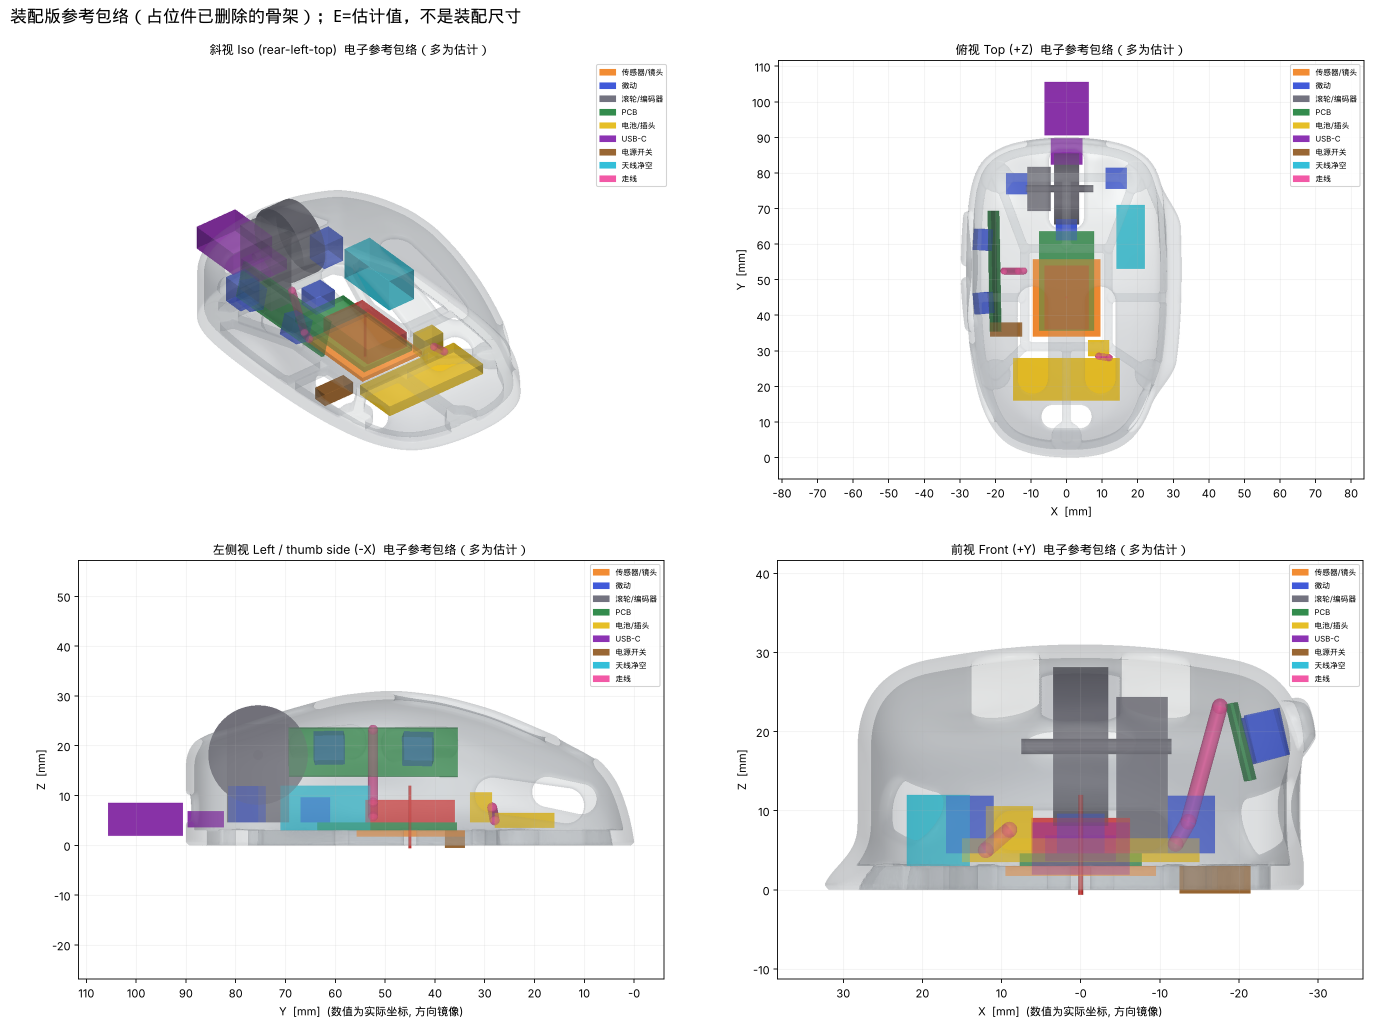
out/v0.1/img/envelopes_sheet.png
