Quietmirror/dsh-new-repo/out/v0.1/img/envelopes_top.png

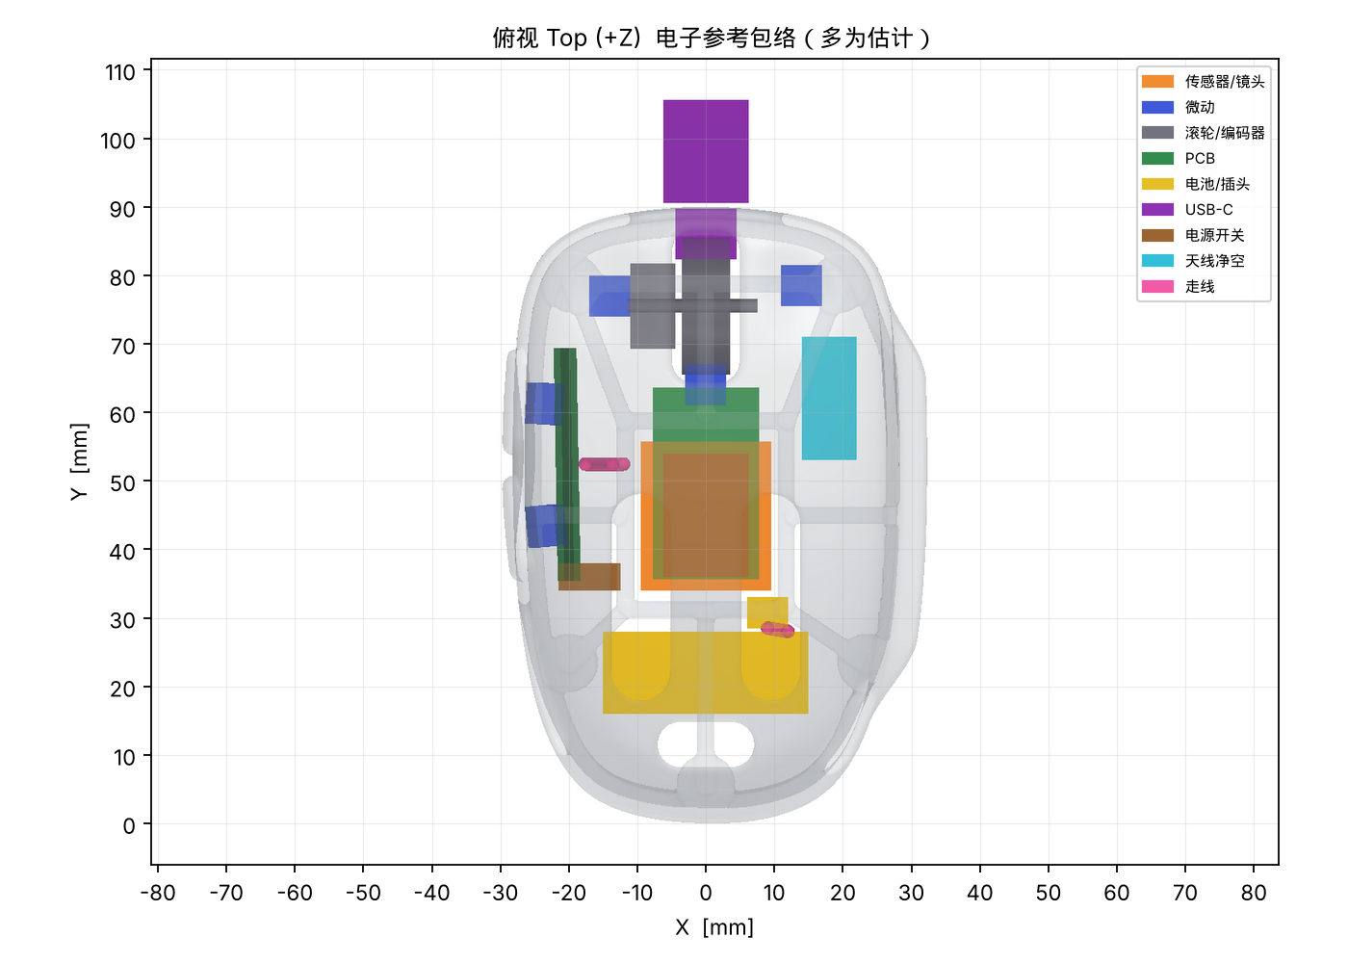
out/v0.1/img/envelopes_top.png
