Quietmirror/dsh-new-repo/out/v0.1/img/overhang_bottom.png

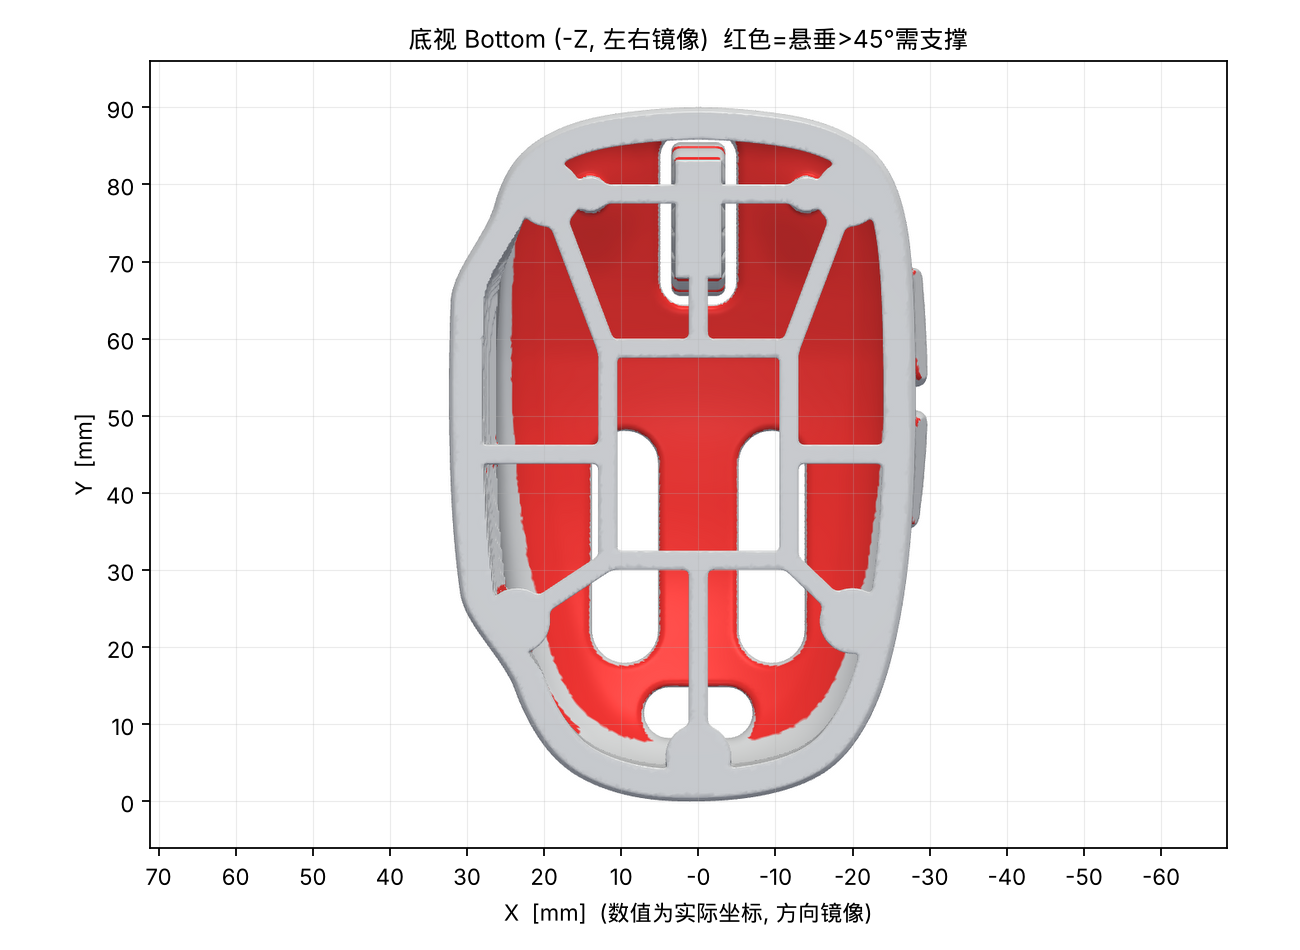
out/v0.1/img/overhang_bottom.png
