Quietmirror/dsh-new-repo/out/v0.1/img/overhang_front.png

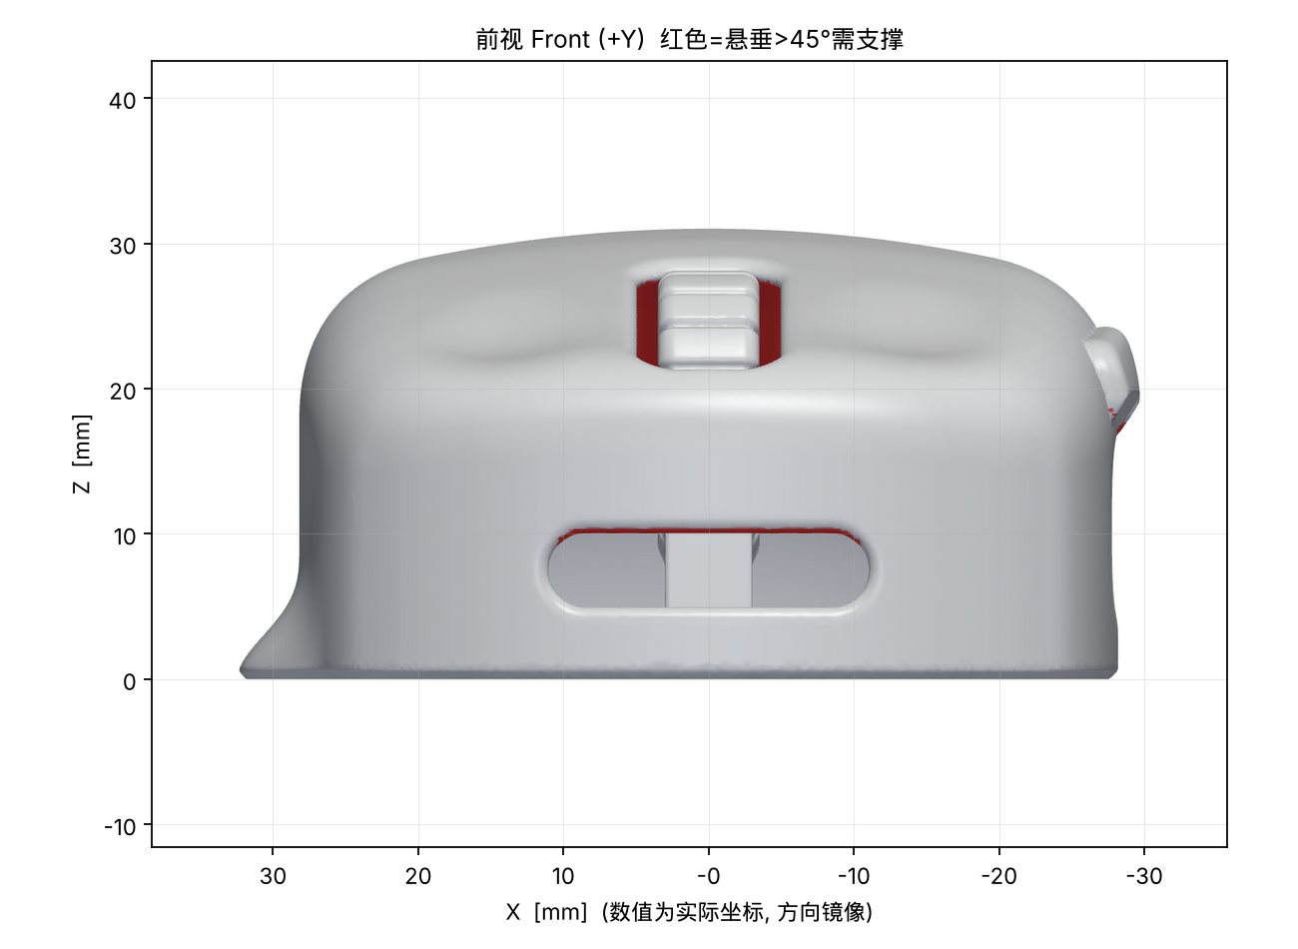
out/v0.1/img/overhang_front.png
