Quietmirror/dsh-new-repo/out/v0.1/img/overhang_left.png

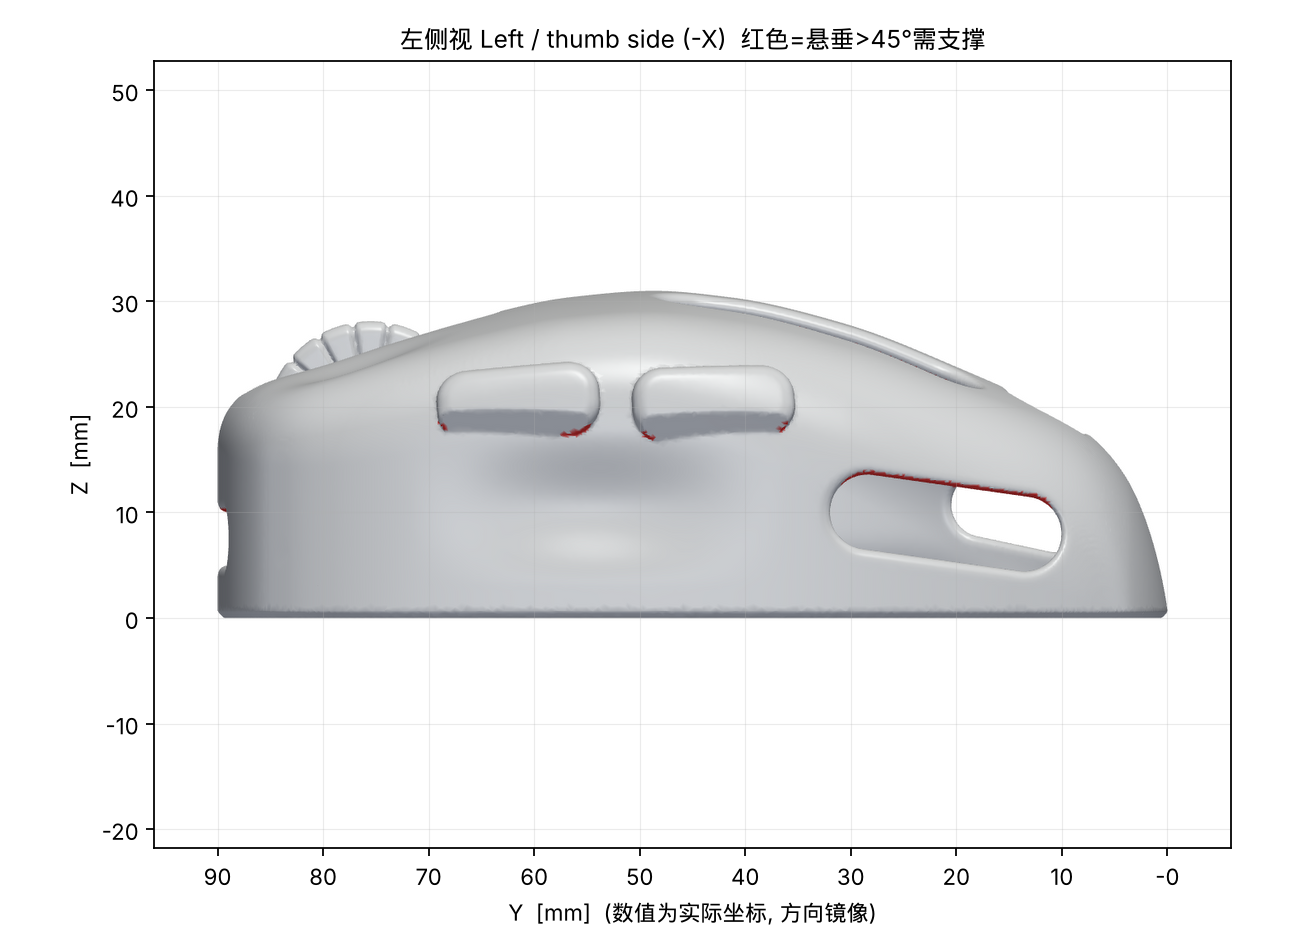
out/v0.1/img/overhang_left.png
