Quietmirror/dsh-new-repo/out/v0.1/img/overhang_sheet.png

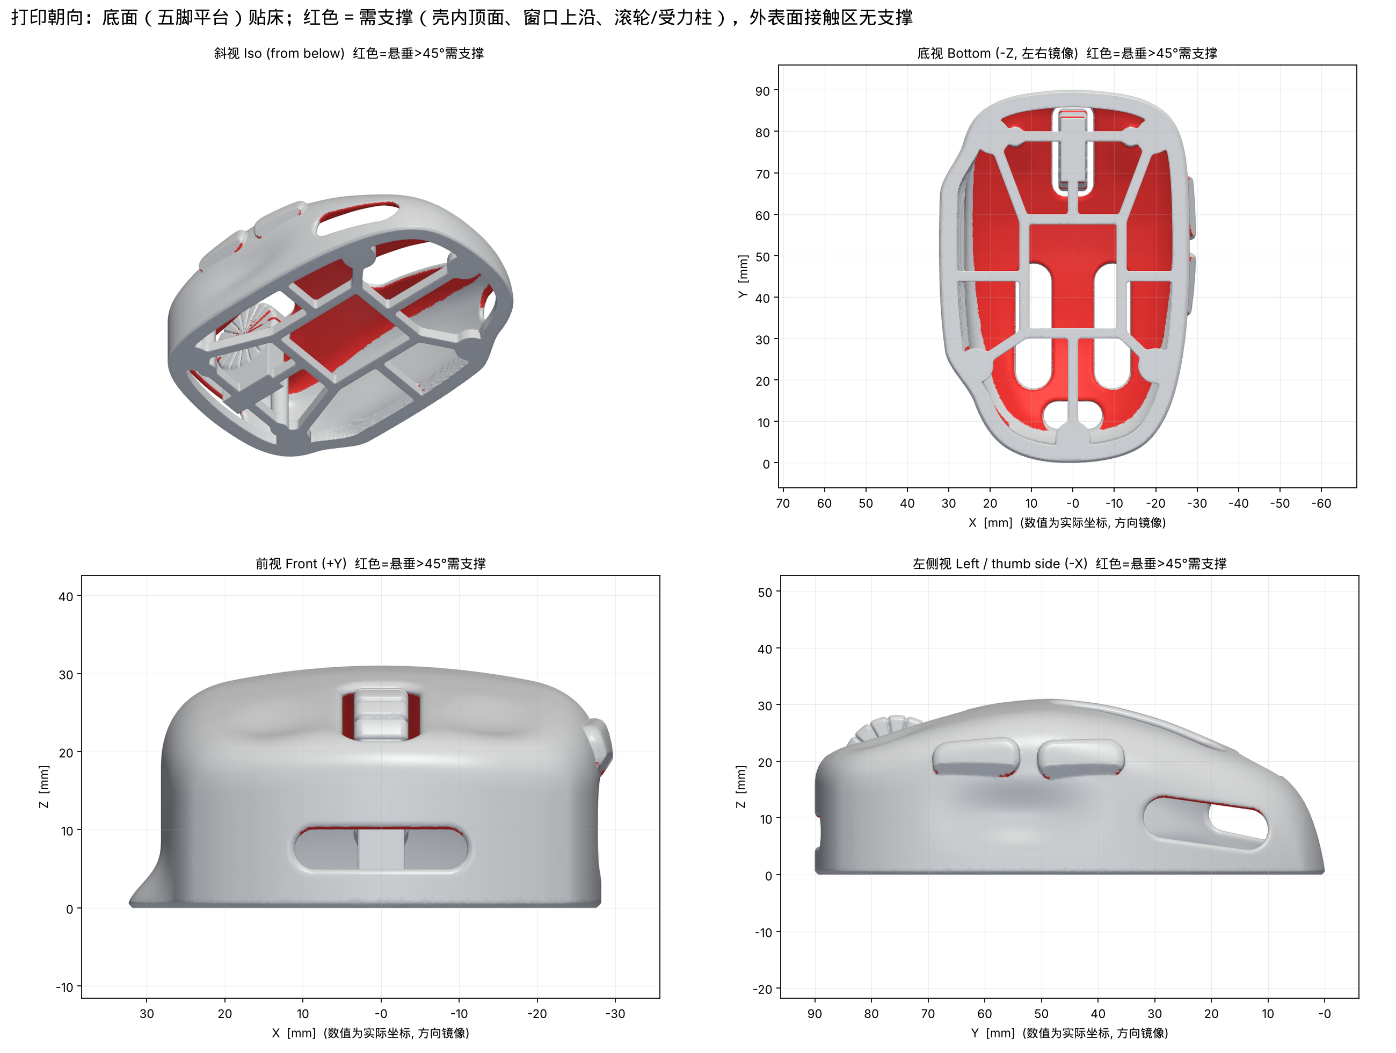
out/v0.1/img/overhang_sheet.png
