Quietmirror/dsh-new-repo/out/v0.1/img/section_x0.png

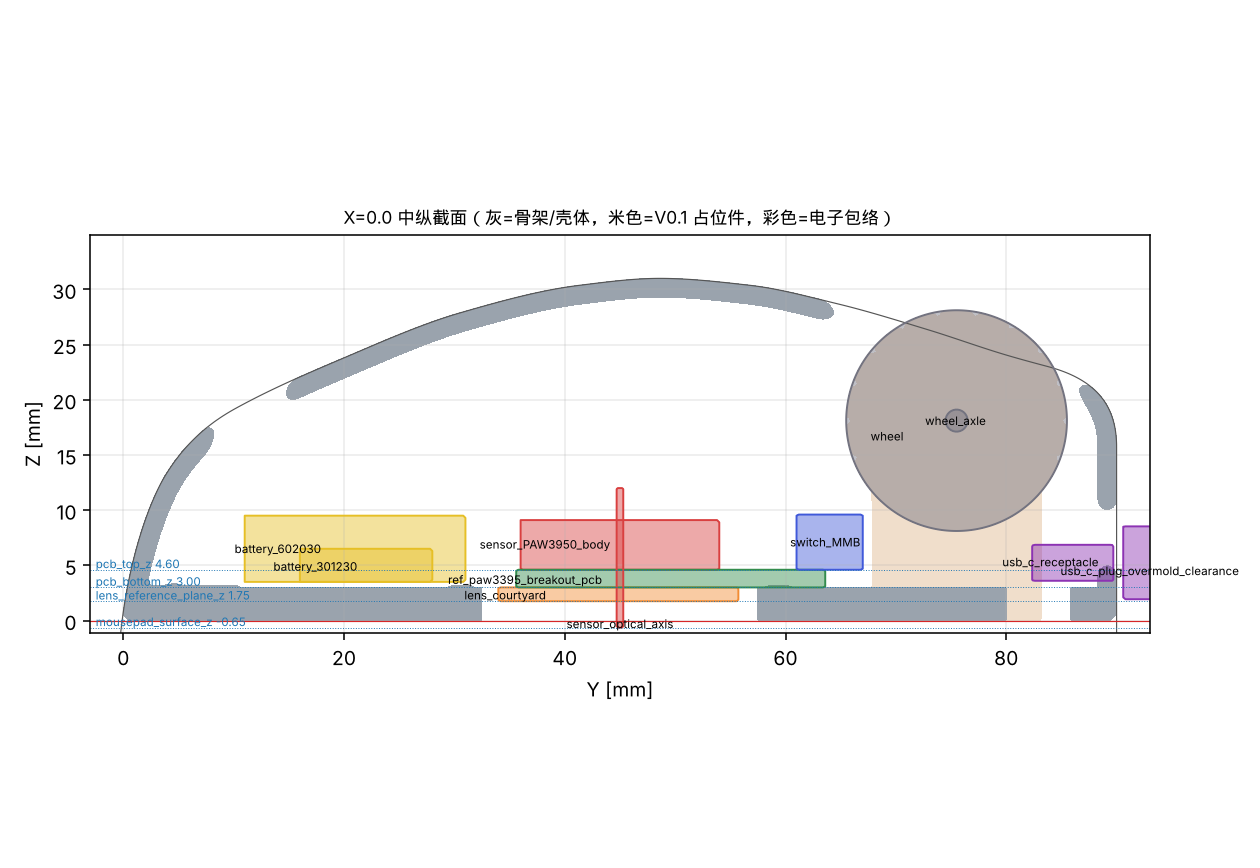
out/v0.1/img/section_x0.png
