Quietmirror/dsh-new-repo/out/v0.1/img/section_y45.png

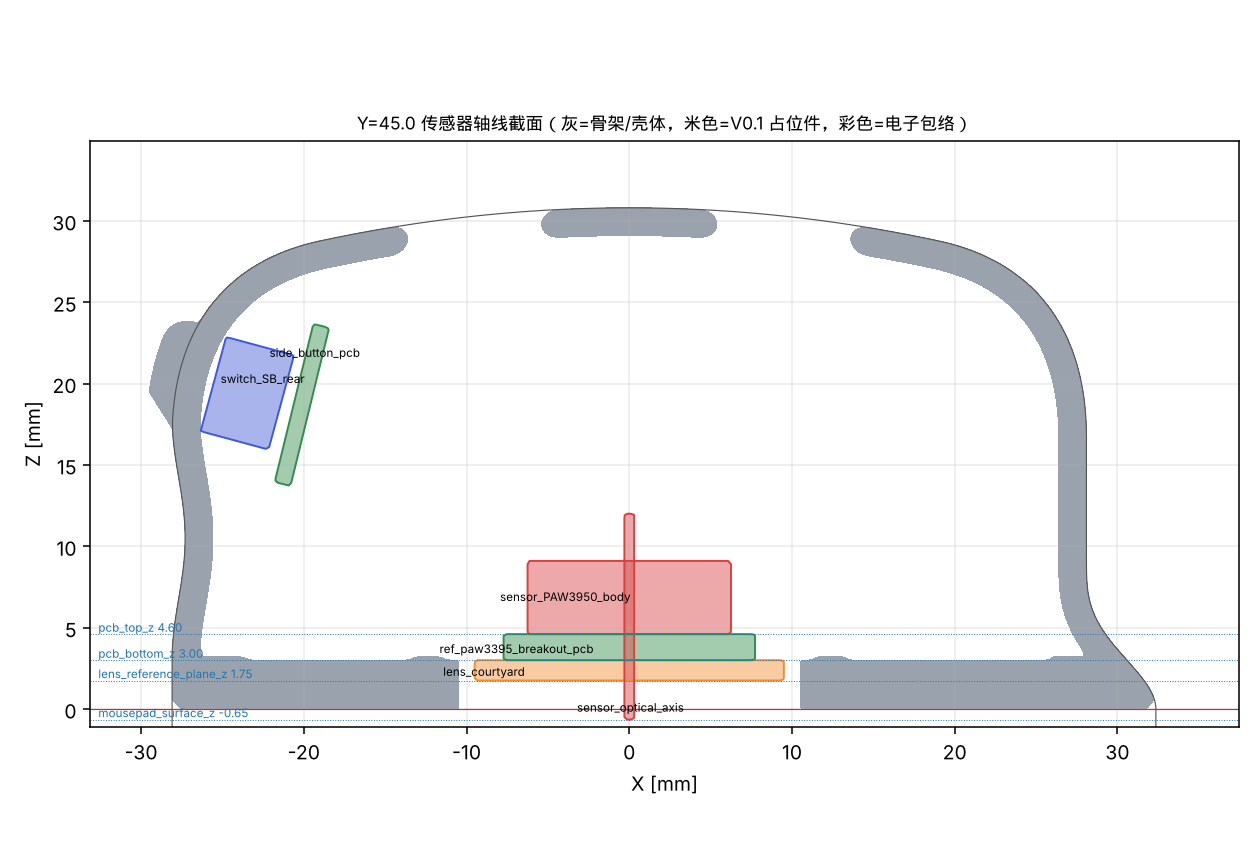
out/v0.1/img/section_y45.png
