Quietmirror/dsh-new-repo/out/v0.1/img/section_y52.png

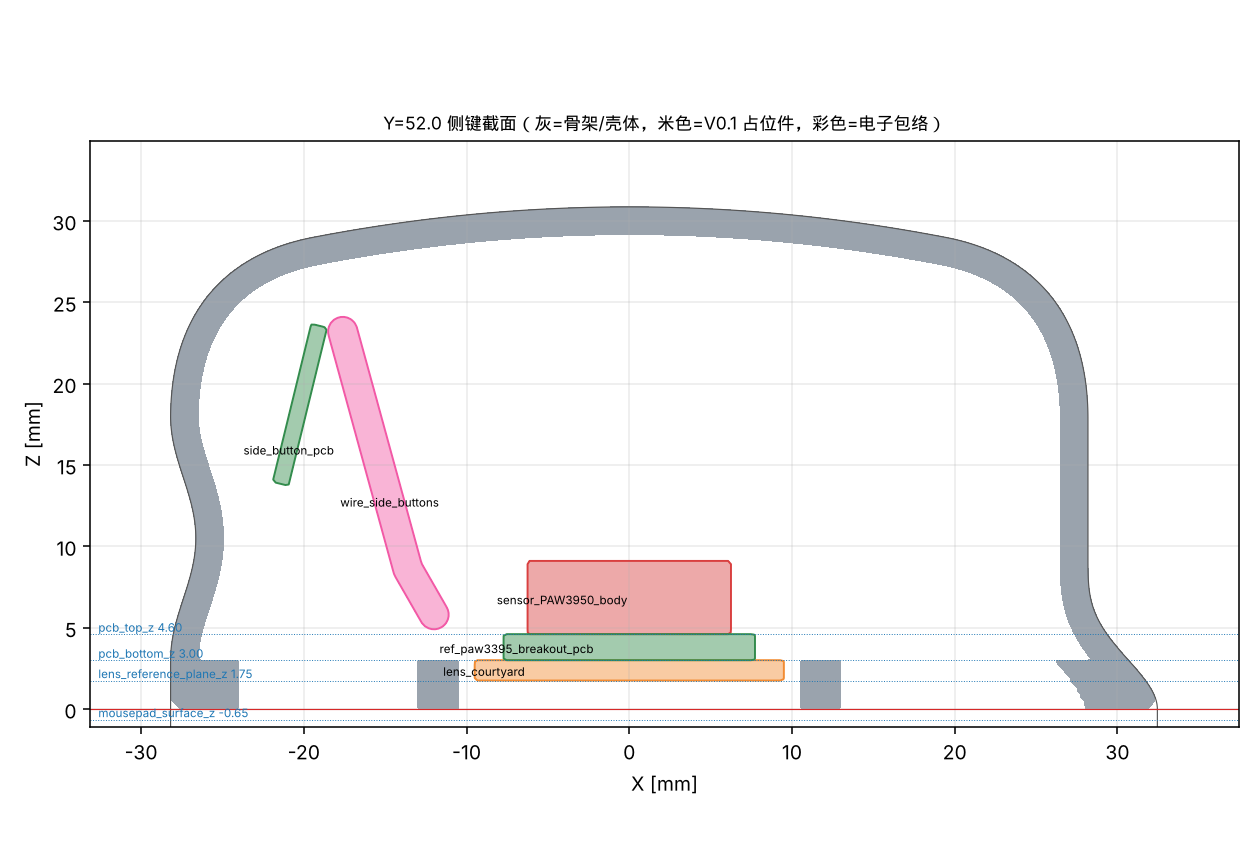
out/v0.1/img/section_y52.png
