Quietmirror/dsh-new-repo/out/v0.1/img/section_y76.png

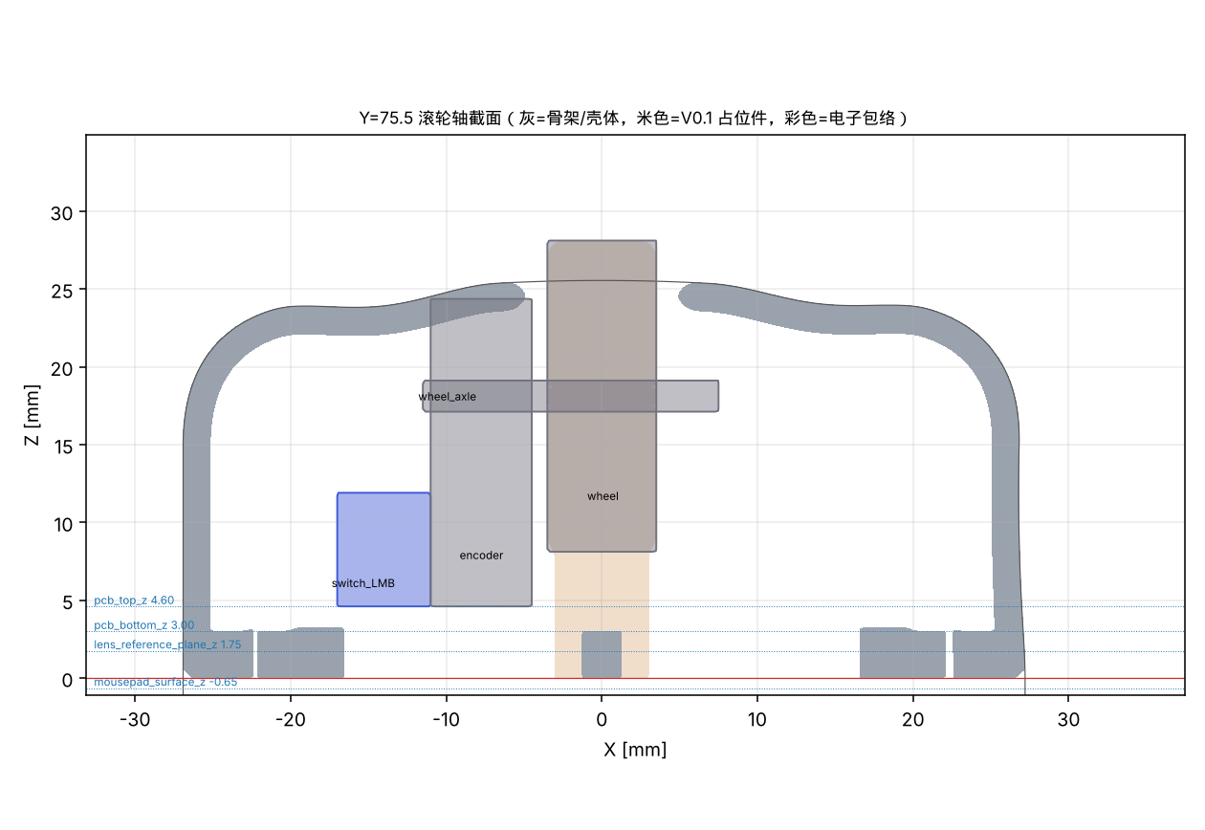
out/v0.1/img/section_y76.png
