Quietmirror/dsh-new-repo/out/v0.1/img/section_z4.png

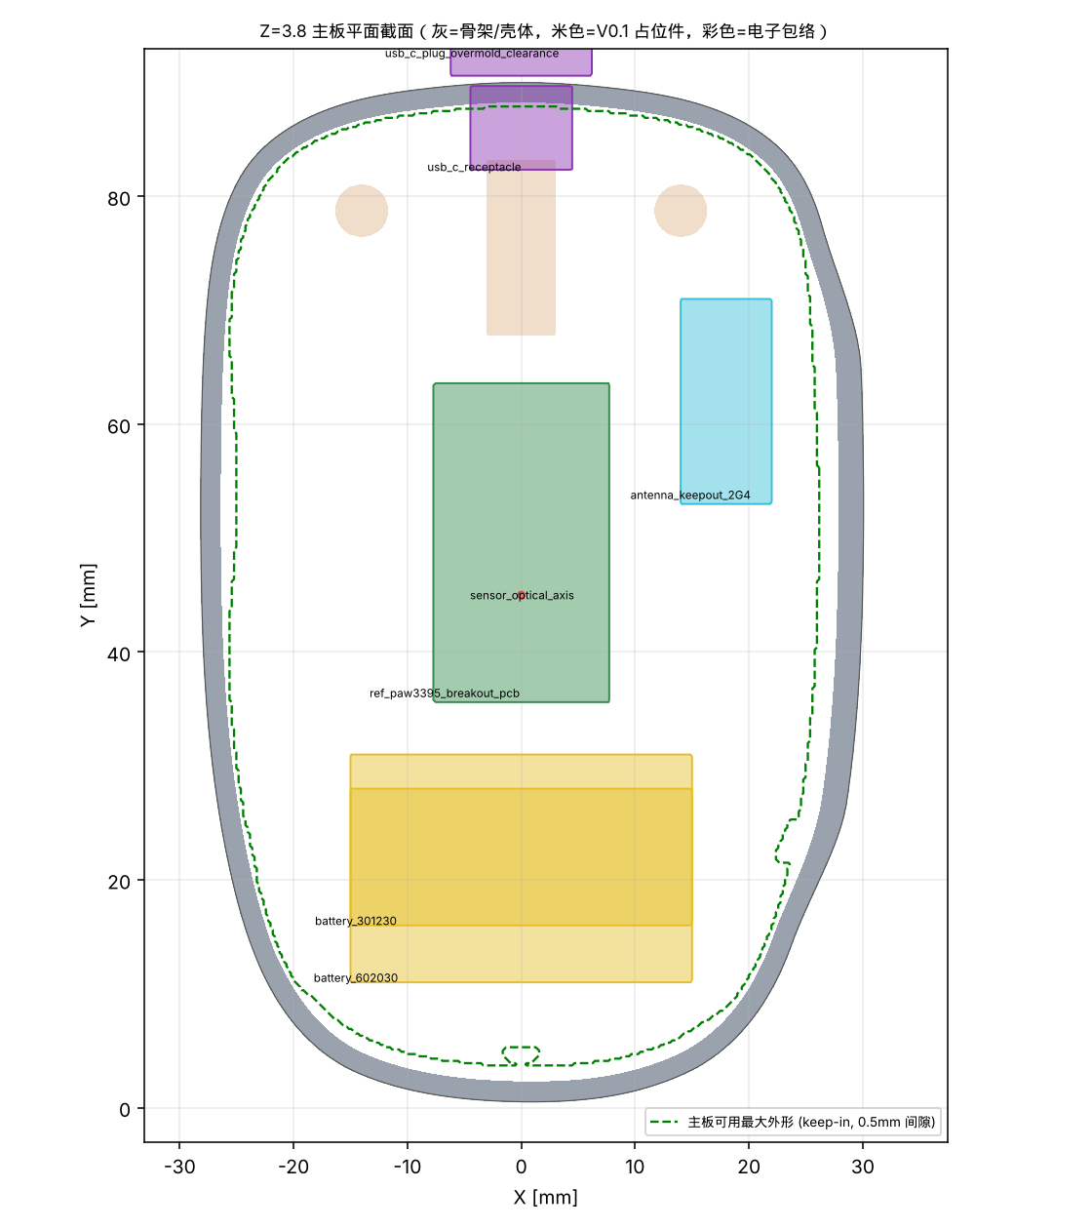
out/v0.1/img/section_z4.png
