Quietmirror/dsh-new-repo/out/v0.1/img/sections_sheet.png

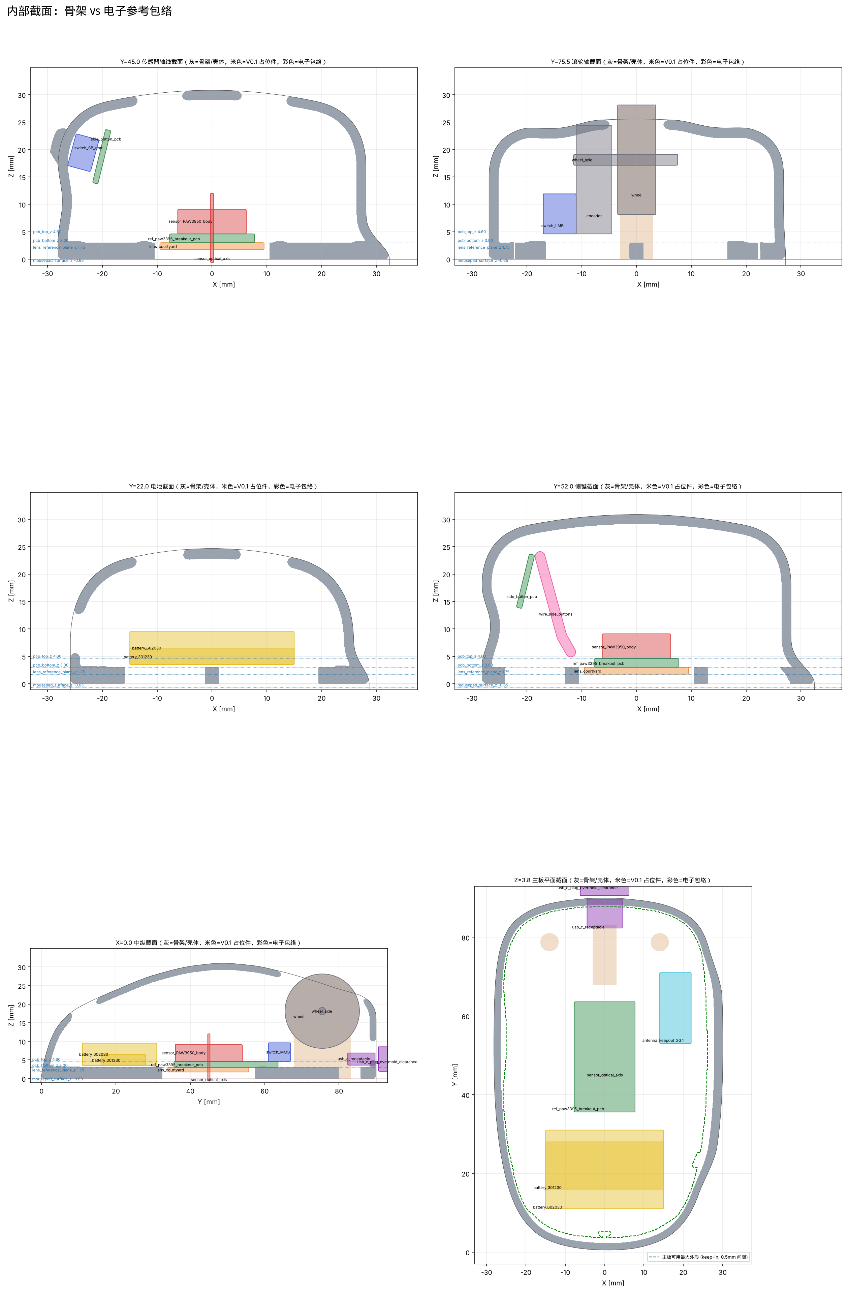
out/v0.1/img/sections_sheet.png
