Quietmirror/dsh-new-repo/out/v0.1/img/thickness_bottom.png

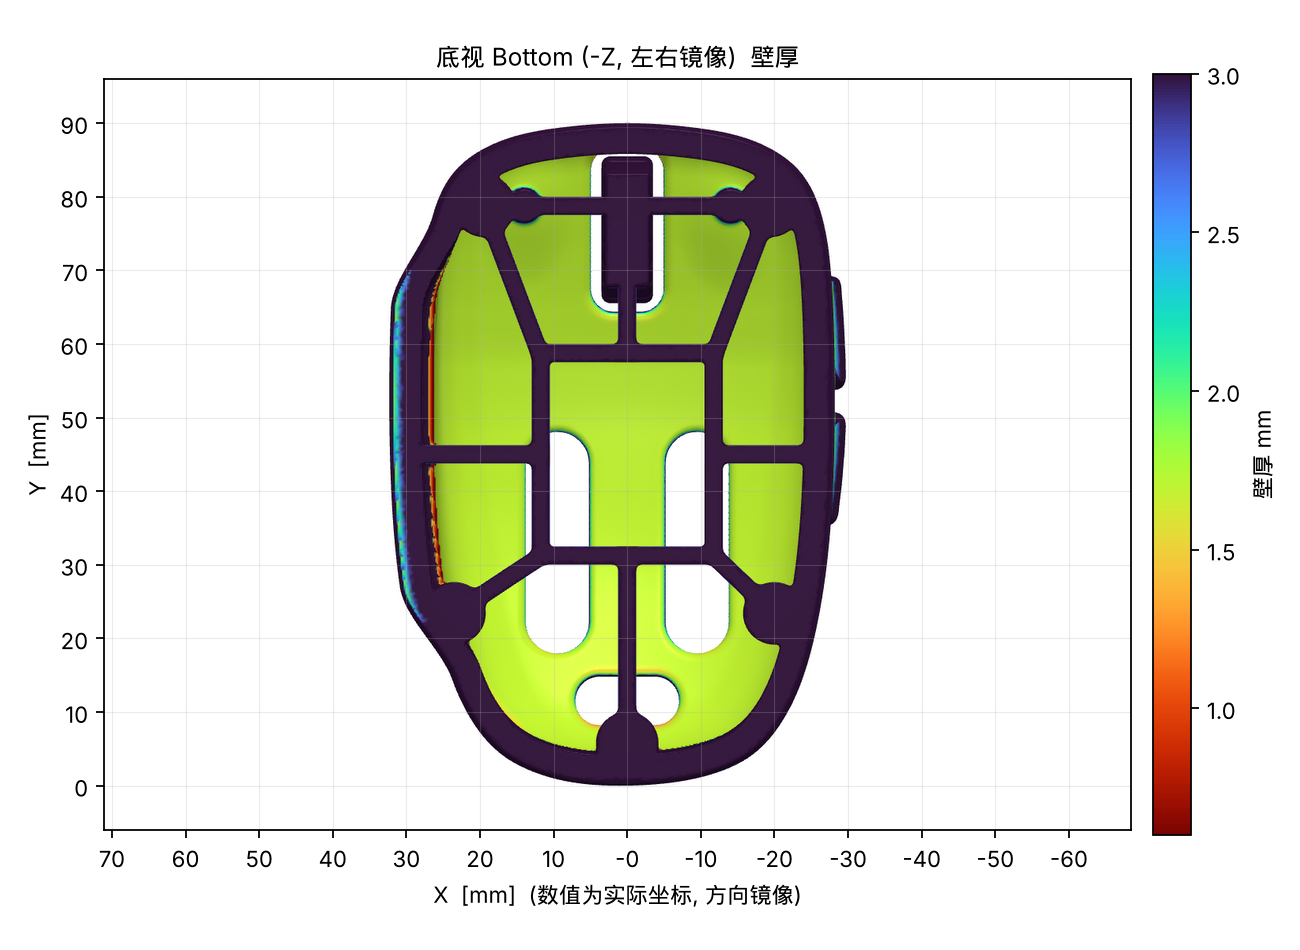
out/v0.1/img/thickness_bottom.png
