Quietmirror/dsh-new-repo/out/v0.1/img/thickness_iso.png

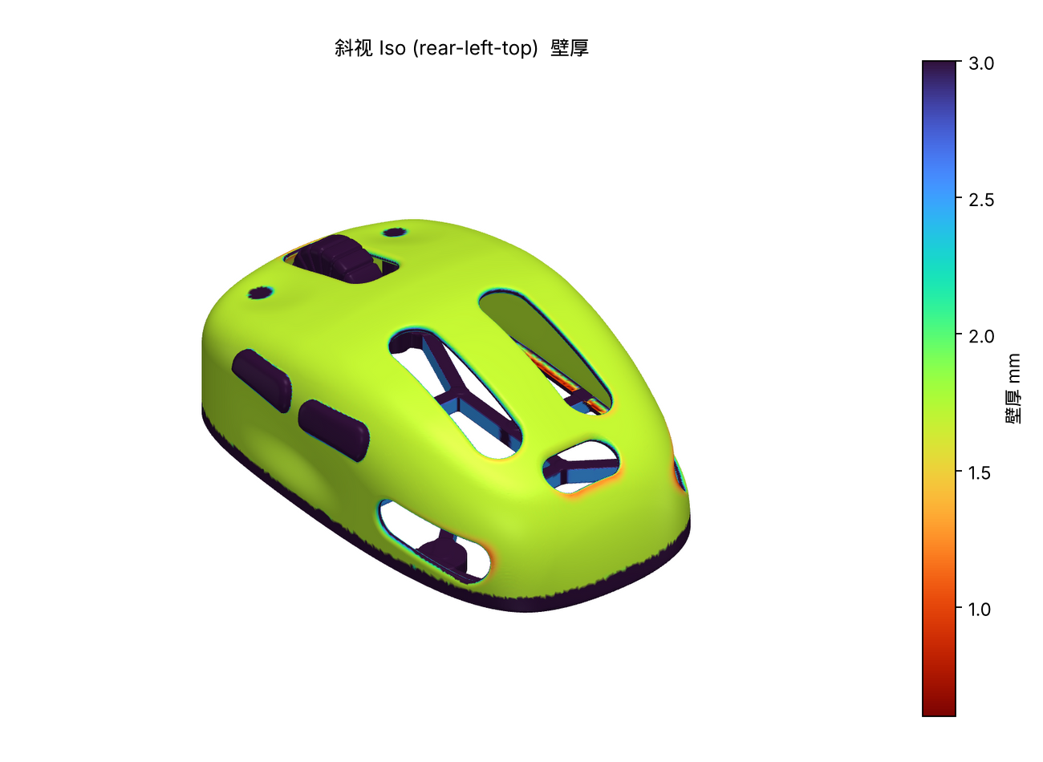
out/v0.1/img/thickness_iso.png
