Quietmirror/dsh-new-repo/out/v0.1/img/thickness_iso_bottom.png

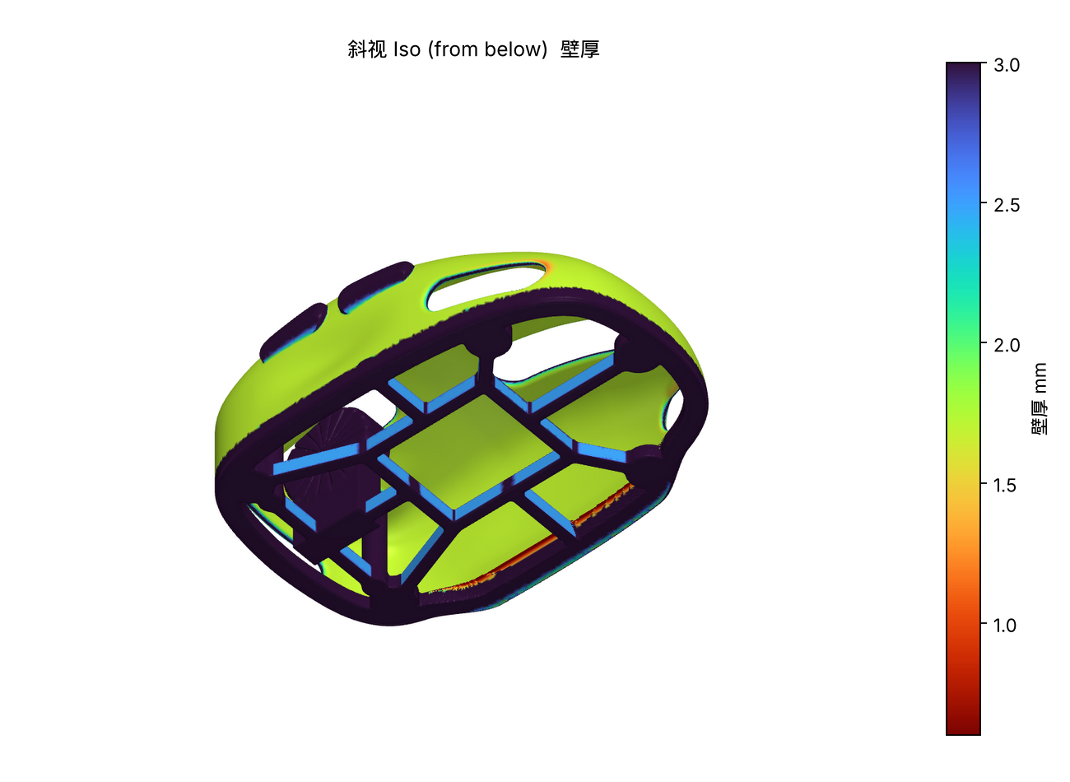
out/v0.1/img/thickness_iso_bottom.png
