Quietmirror/dsh-new-repo/out/v0.1/img/thickness_sheet.png

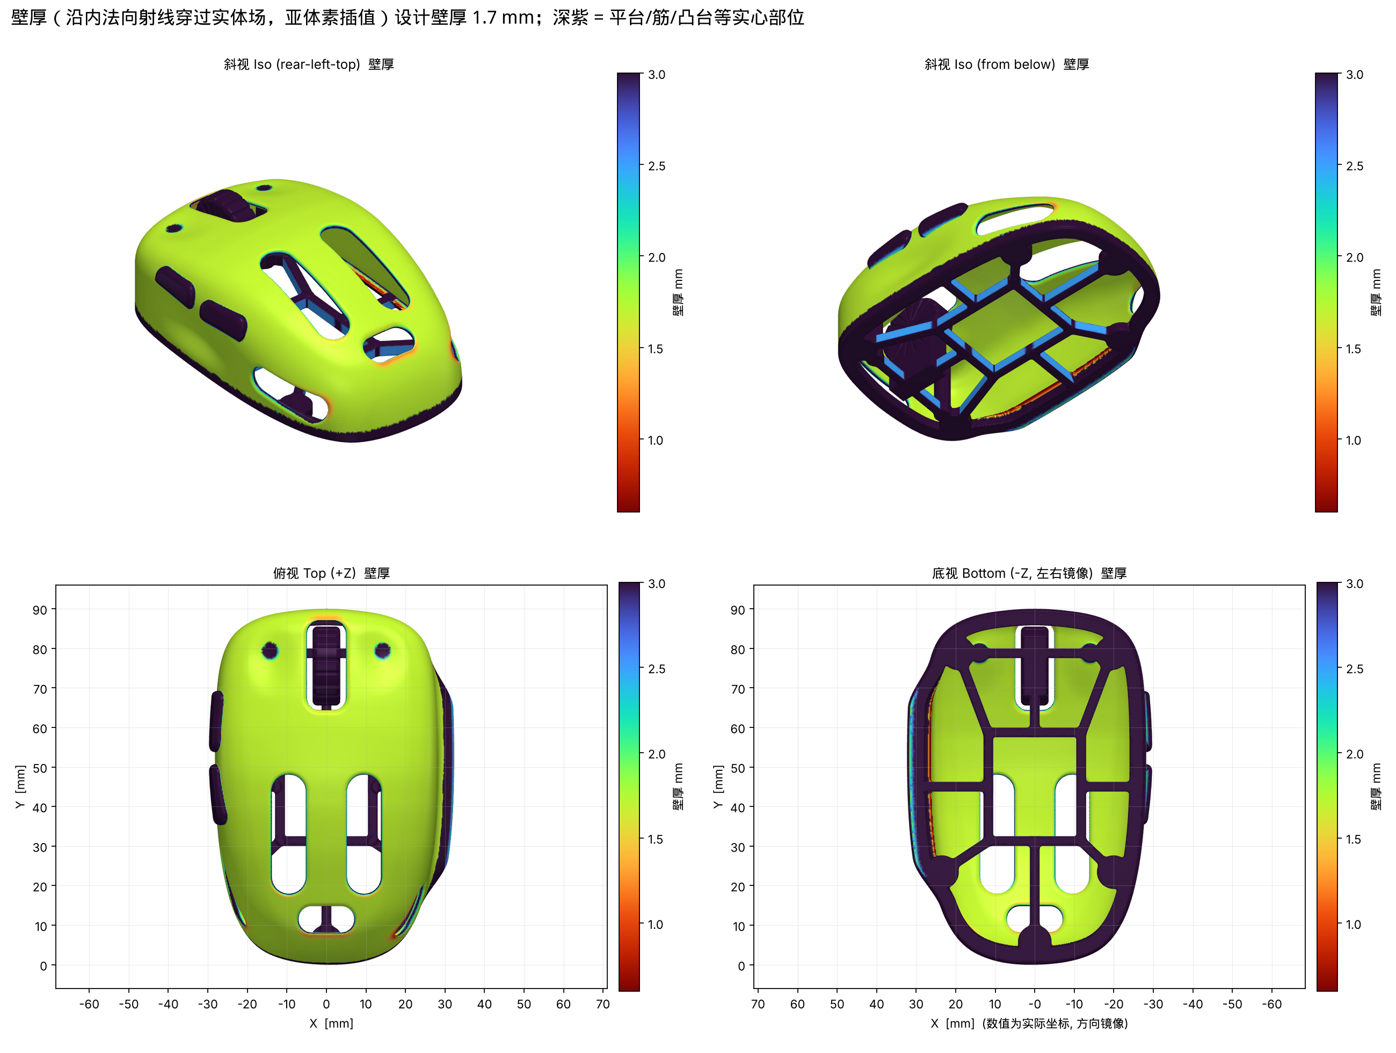
out/v0.1/img/thickness_sheet.png
