Quietmirror/dsh-new-repo/out/v0.1/img/thickness_top.png

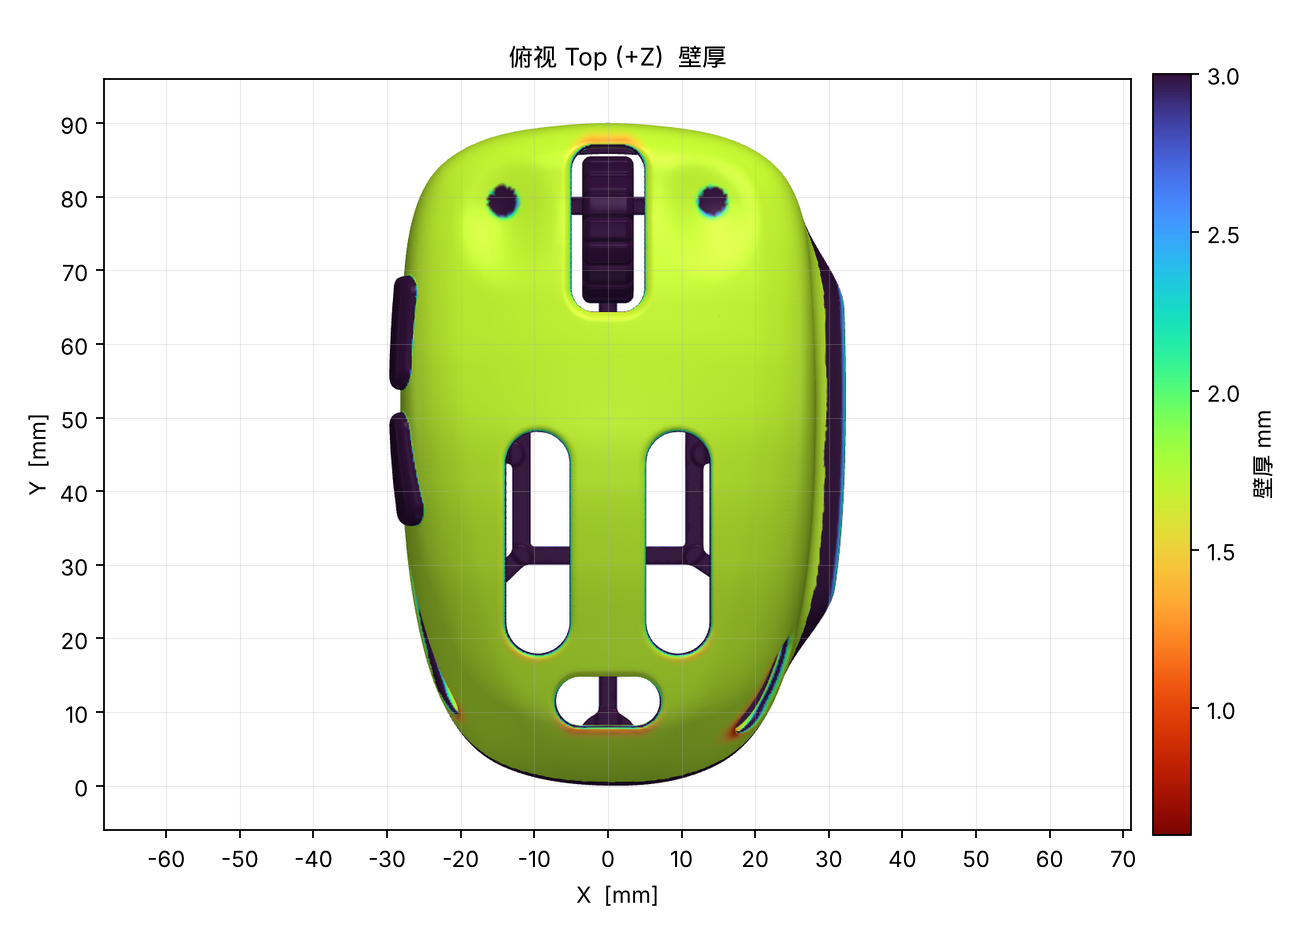
out/v0.1/img/thickness_top.png
