Quietmirror/dsh-new-repo/out/v0.1/img/view_bottom.png

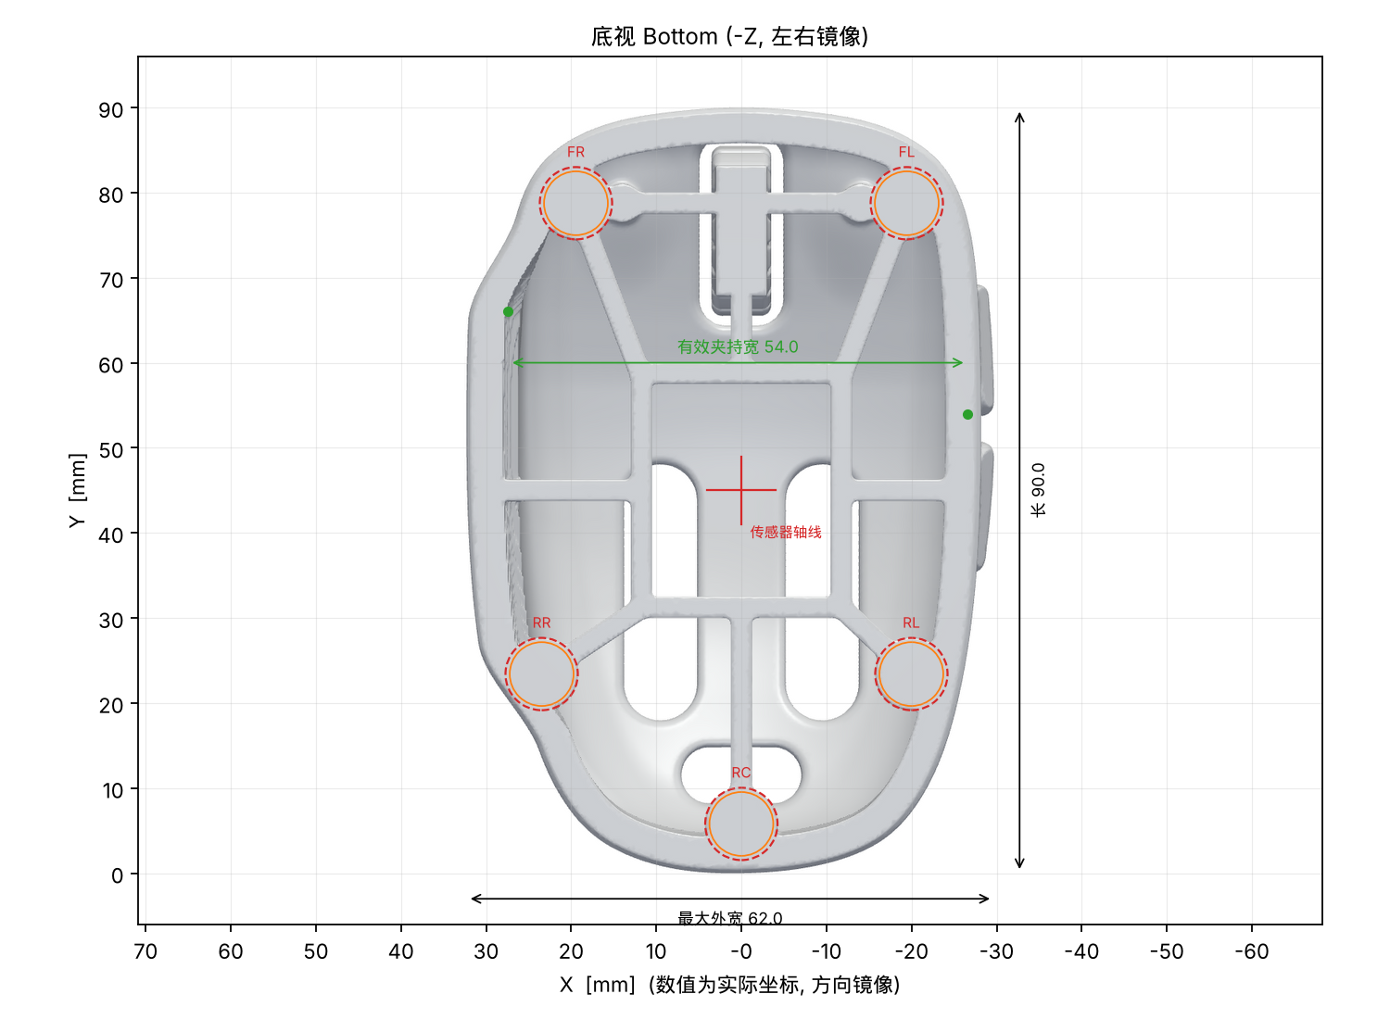
out/v0.1/img/view_bottom.png
