Quietmirror/dsh-new-repo/out/v0.1/img/view_front.png

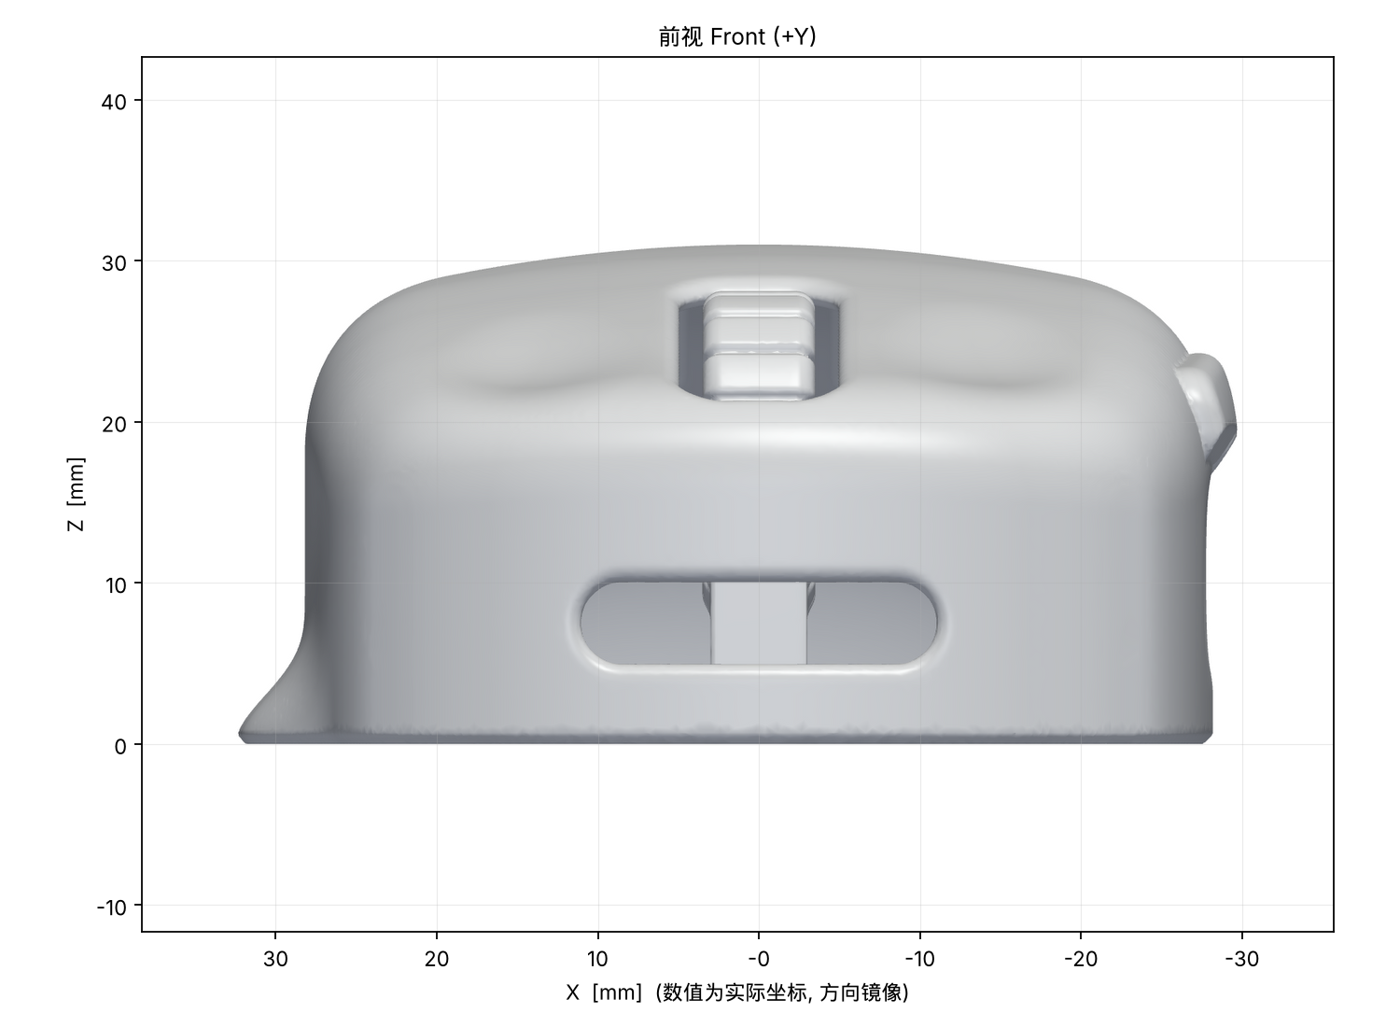
out/v0.1/img/view_front.png
