Quietmirror/dsh-new-repo/out/v0.1/img/view_iso.png

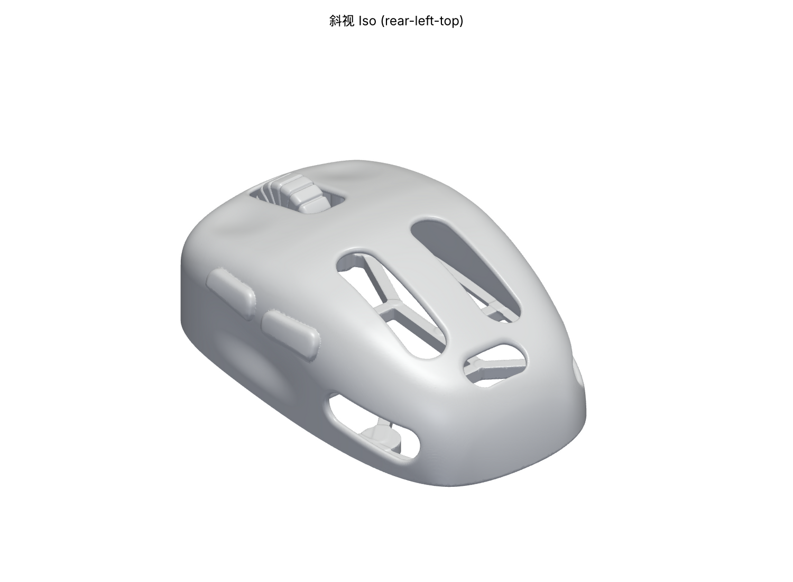
out/v0.1/img/view_iso.png
