Quietmirror/dsh-new-repo/out/v0.1/img/view_iso_fr.png

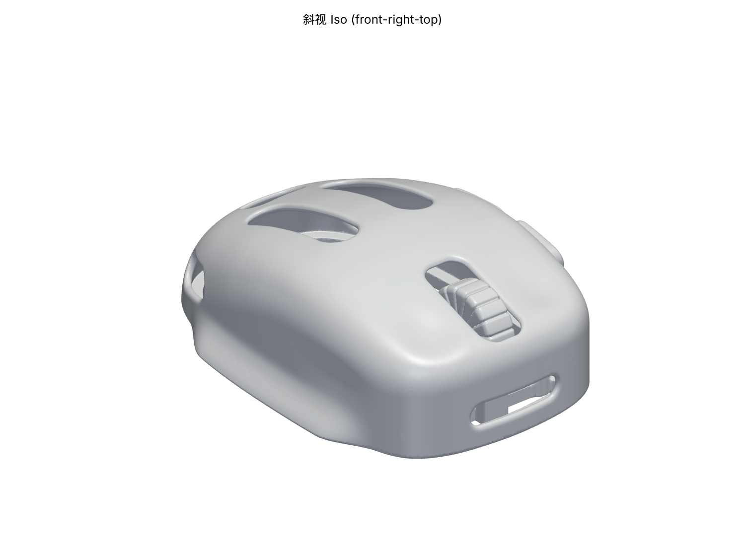
out/v0.1/img/view_iso_fr.png
