Quietmirror/dsh-new-repo/out/v0.1/img/view_left.png

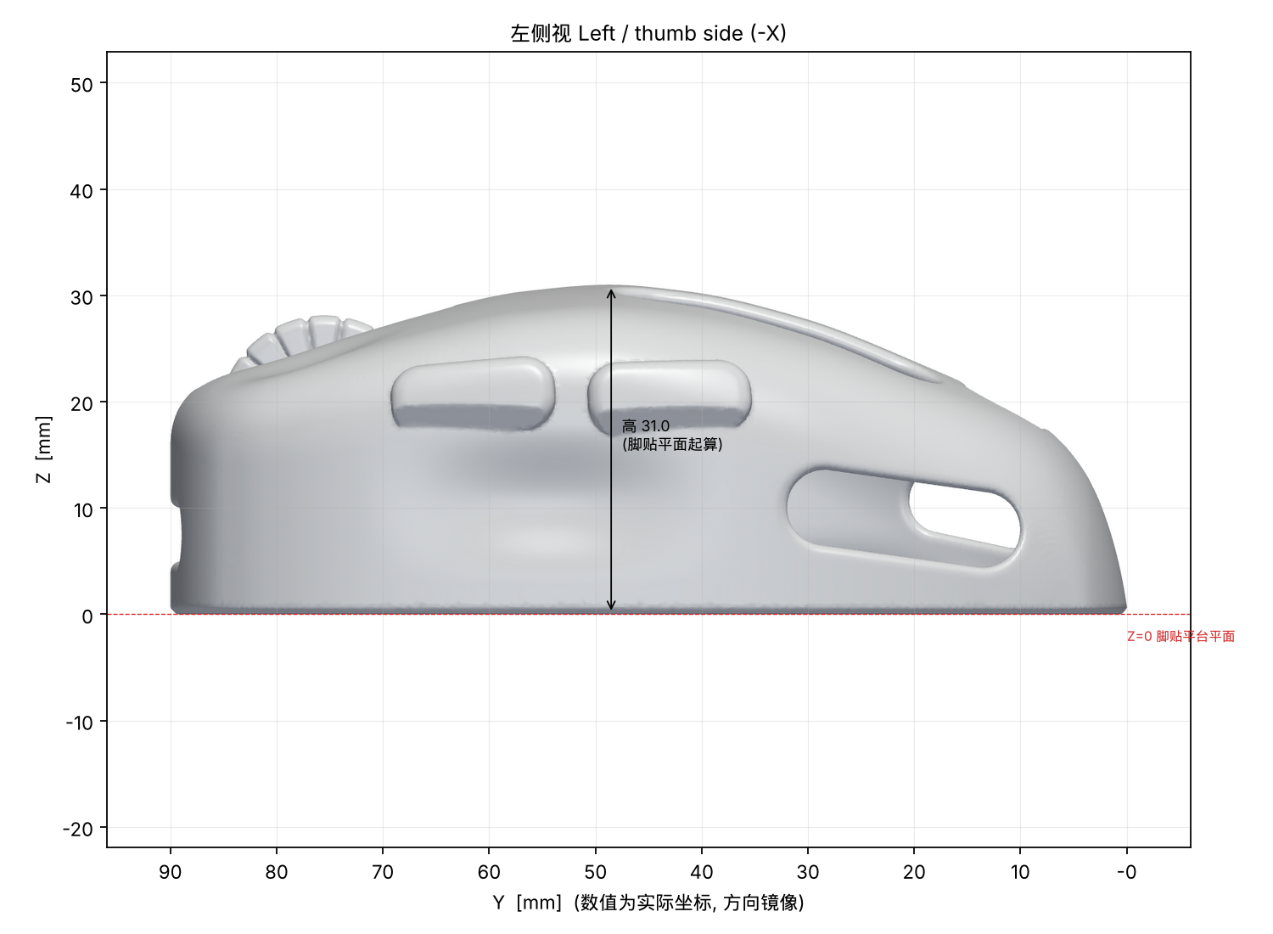
out/v0.1/img/view_left.png
