Quietmirror/dsh-new-repo/out/v0.1/img/view_rear.png

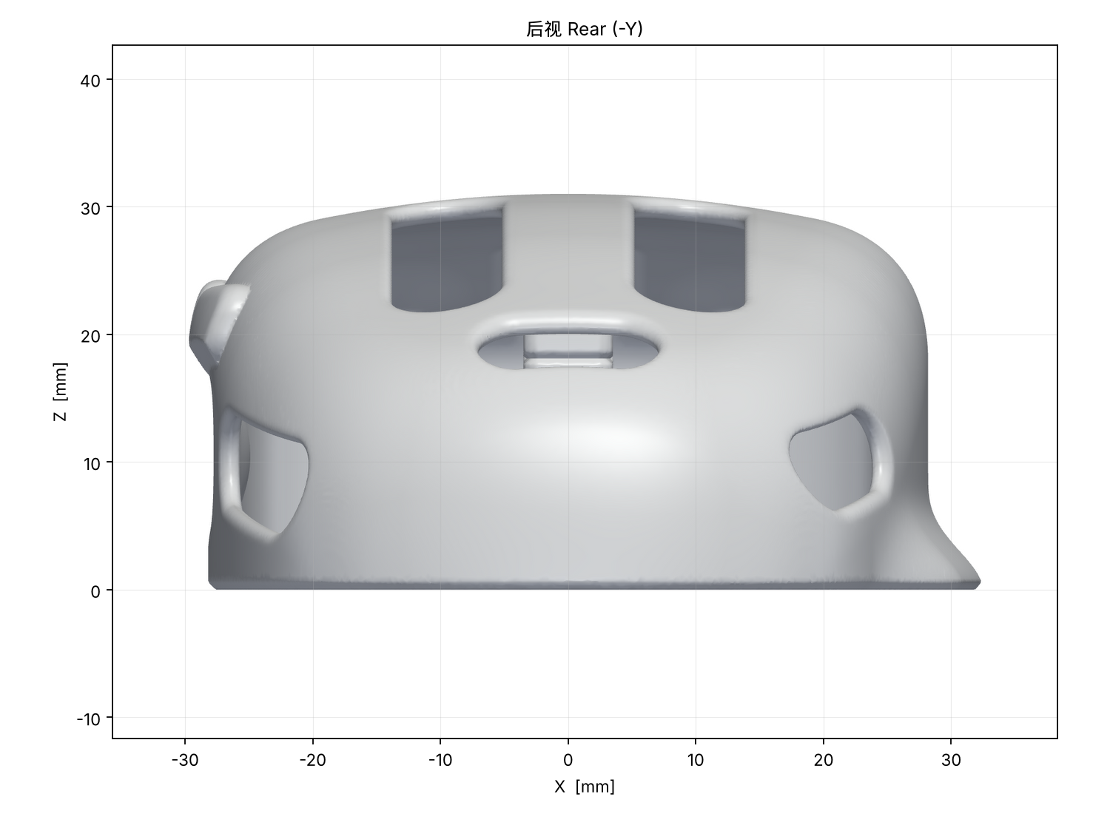
out/v0.1/img/view_rear.png
