Quietmirror/dsh-new-repo/out/v0.1/img/view_right.png

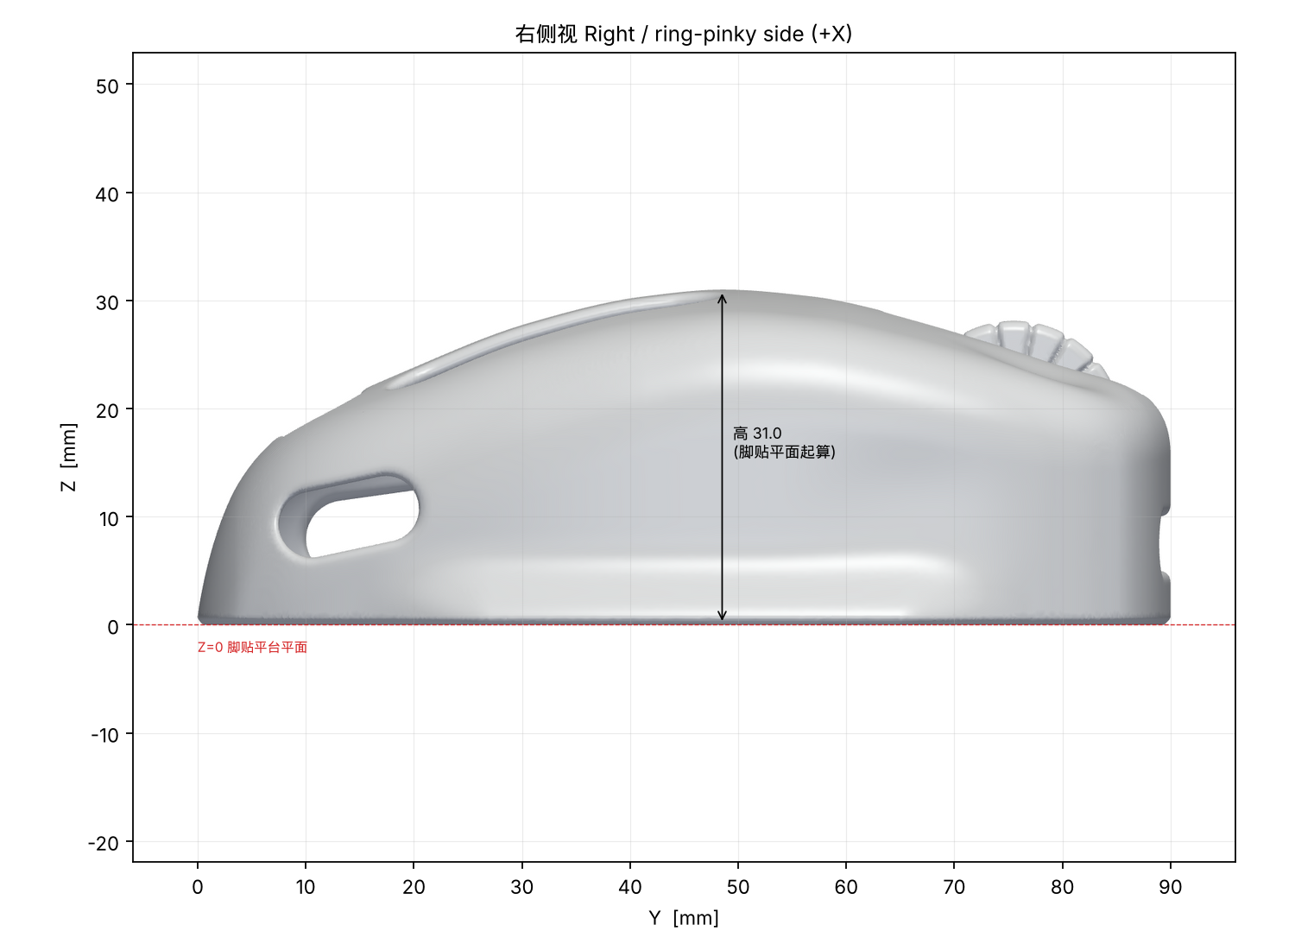
out/v0.1/img/view_right.png
