Quietmirror/dsh-new-repo/out/v0.1/main_board_keepin_outline.dxf

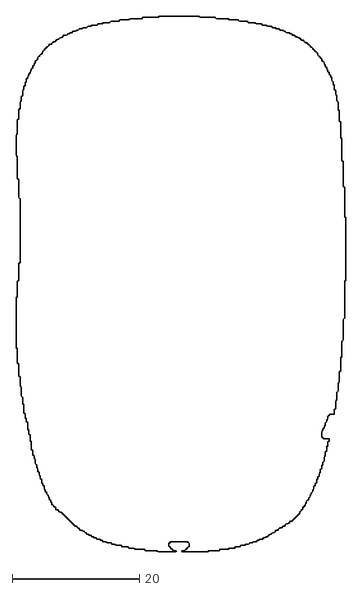
[picture p36: CAD file, 2026-10-14]
out/v0.1/main_board_keepin_outline.dxf
51.8 x 84.2
