Quietmirror/dsh-new-repo/out/v0.1/outer_skin_nurbs_ref_v01.step

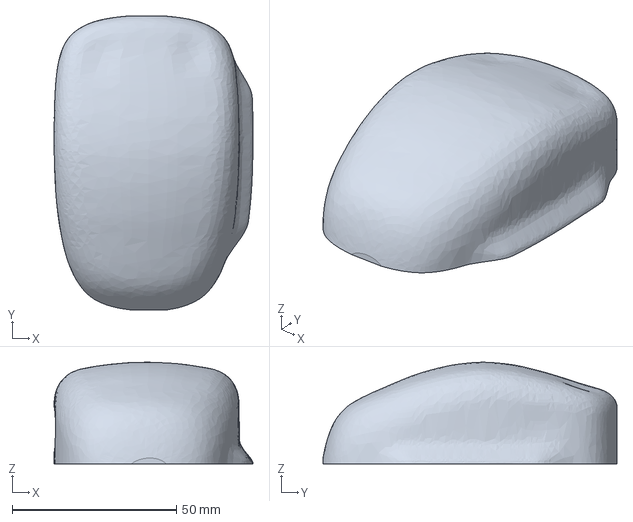
[picture p37: CAD file, 2026-10-14]
out/v0.1/outer_skin_nurbs_ref_v01.step
60.6 x 89.6 x 31.0 mm
