Quietmirror/dsh-new-repo/out/v0.1/electronics_envelopes_v01.step

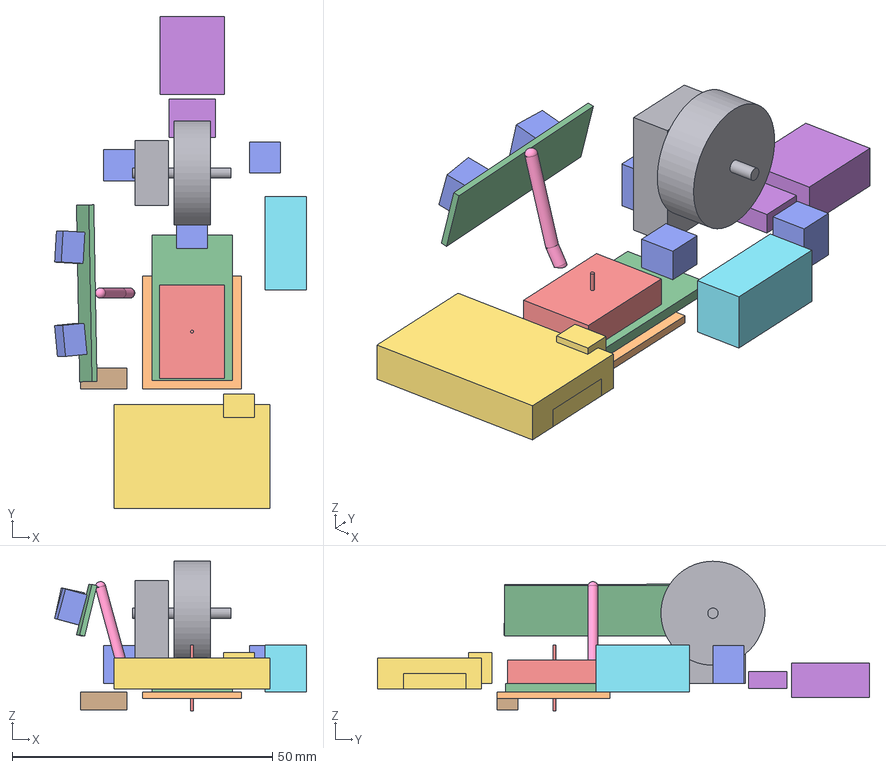
[picture p38: CAD file, 2026-10-14]
out/v0.1/electronics_envelopes_v01.step
48.5 x 94.6 x 28.8 mm
lens_courtyard
sensor_PAW3950_body
ref_paw3395_breakout_pcb
sensor_optical_axis
switch_LMB
switch_RMB
wheel
wheel_axle
encoder
switch_MMB
switch_SB_front
switch_SB_rear
side_button_pcb
battery_301230
battery_plug
usb_c_receptacle
usb_c_plug_overmold_clearance
power_switch
antenna_keepout_2G4
wire_side_buttons
wire_battery
battery_602030
