Quietmirror/dsh-new-repo/out/v0.1/ref_skeleton_without_placeholders.stl

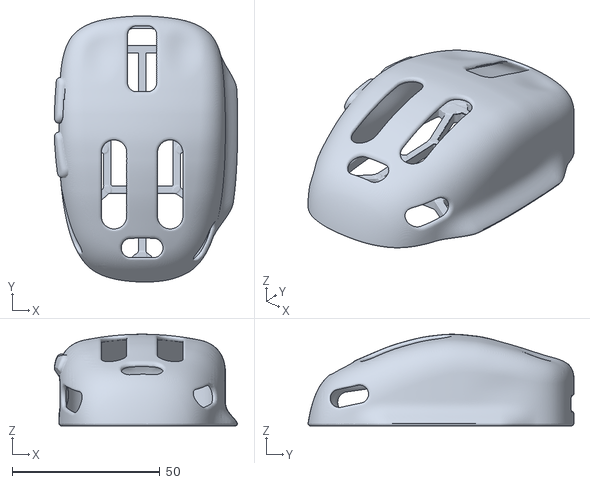
[picture p39: CAD file, 2026-10-14]
out/v0.1/ref_skeleton_without_placeholders.stl
62.0 x 90.0 x 31.0
