Quietmirror/dsh-new-repo/out/v0.1/fingertip_v01_trial_grip.3mf

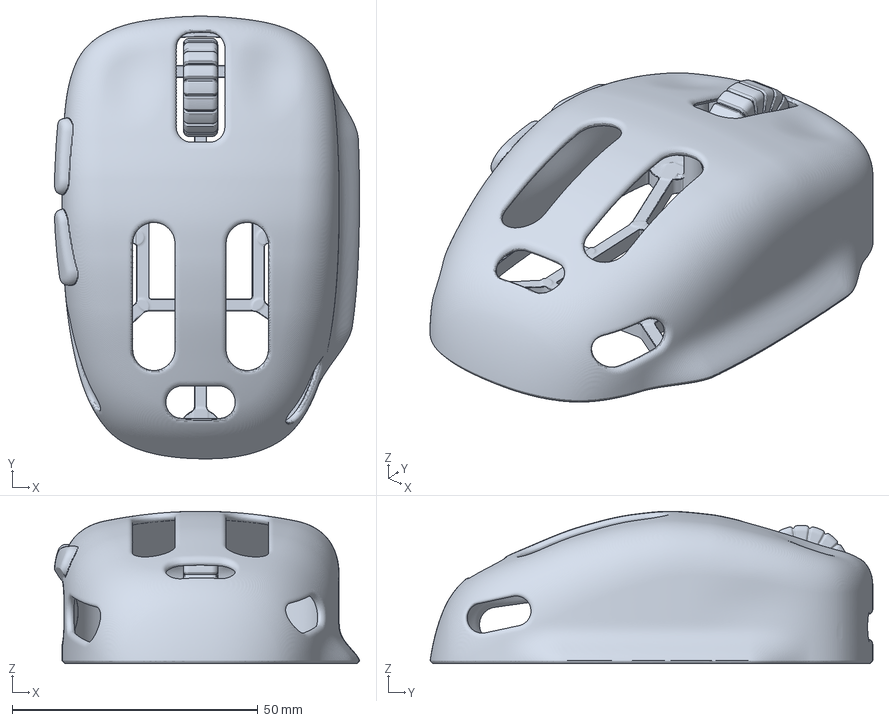
[picture p40: CAD file, 2026-10-14]
out/v0.1/fingertip_v01_trial_grip.3mf
62.0 x 90.0 x 31.0 mm
