Quietmirror/dsh-new-repo/(list of files, cad)

Other CAD files:
out/v0.1/electronics_envelopes_v01.stl
out/v0.1/fingertip_v01_trial_grip.stl
